SP6GK/Presto-Transverter/ECAD/Simulations_0006_PrestoMB/TPS26600 - Design Calculator Rev1p0.xlsx

Sheet: Calculation Sheet
TPS26600 Design Calculator Tool
Constants Cells | Input / Select Cells | Calculation Cells
 | Calculated, but can be over-ridden by the user. Note: Once cells are over-ridden, new calculation sheet should be used for the next design
Parameter | Description | Value | Units | Tolerance
VIN (max) | Maximum System Input Voltage | 14.0 | V
UVset | Undervoltage Lockout Threshold | 8.00 | V
OVset | Over Voltage Cut-Off Threshold | 16.00 | V
Cout | Load Capacitance | 330.0 | µF | 10%
TA (max) | Maximum Ambient Temperature | TA = 85C | °C
RLstart | Load during start-up (Assumed to be resistive) | 30.0 | Ω
Imax | Maximum continuous load current | 1.0 | A
ILimit | Current Limit, 10% higher than the maximum continuous load current | 1.10 | A
UVLO, OVP Calculations
R3_sel | Select a value in the range from 10k to 249k | 33.0 | kΩ | 1.0% |  |  |  | 330
R2_cal | Calculated value of Resistor at UVLO pin | 33.0 | kΩ |  |  | 7.69 | Power Fail (VIN Falling) | 330
R1_cal | Calculated value of Resistor at IN pin | 377.7 | kΩ |  |  | 8.32 | UVLO (VIN Rising) | 377.697479
SELECT THE CLOSEST POSSIBLE RESISTANCE VALUE FOR R1, R2, R3 |  |  |  |  |  | 16.84 | OVP (VIN Rising)
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
