SP6GK/Presto-Transverter/ECAD/KiCad_0006_PrestoMB_rev01a/ScoreS3.png

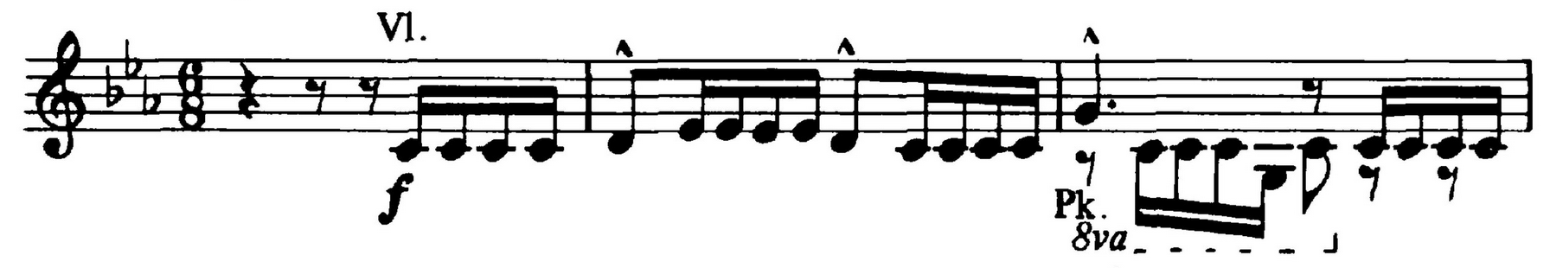
ECAD/KiCad_0006_PrestoMB_rev01a/ScoreS3.png
