SP6GK/Presto-Transverter/Photos/CH_under_development2.png

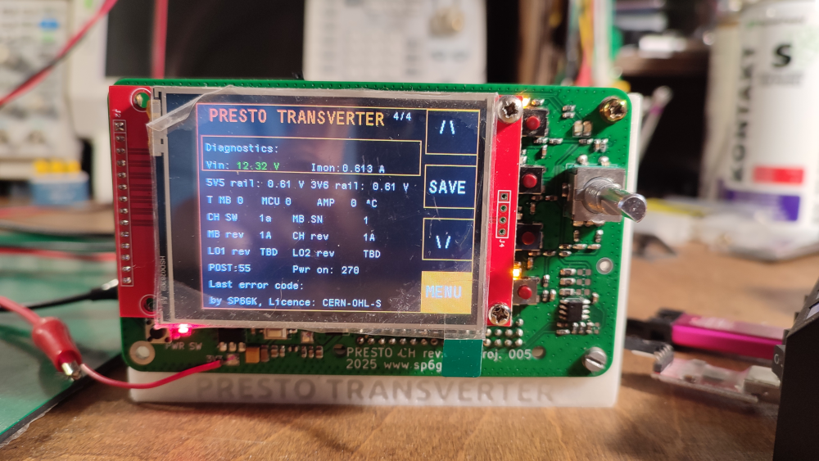
Photos/CH_under_development2.png
