SP6GK/Presto-Transverter/Photos/CH_under_development3.png

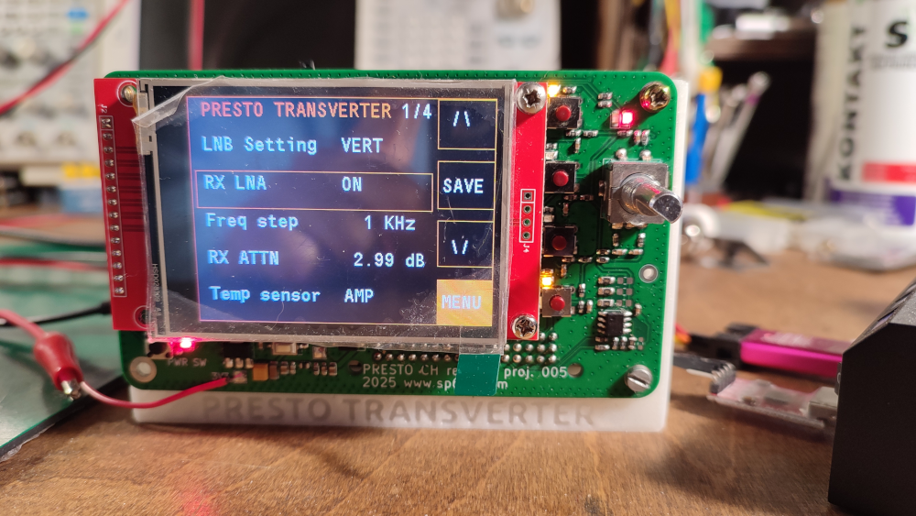
Photos/CH_under_development3.png
