SP6GK/Presto-Transverter/Photos/IMG_20250809_144910.jpg

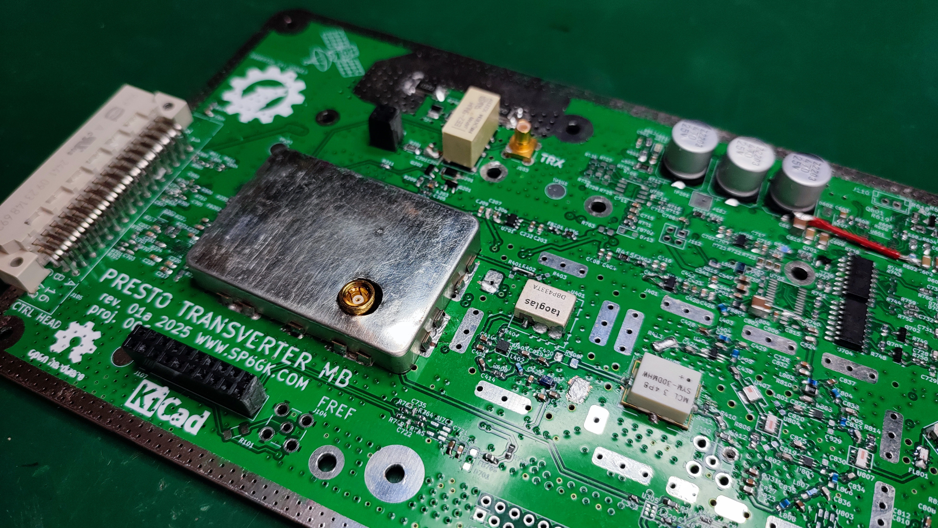
Photos/IMG_20250809_144910.jpg
