SP6GK/Presto-Transverter/Photos/IMG_20250809_145022.jpg

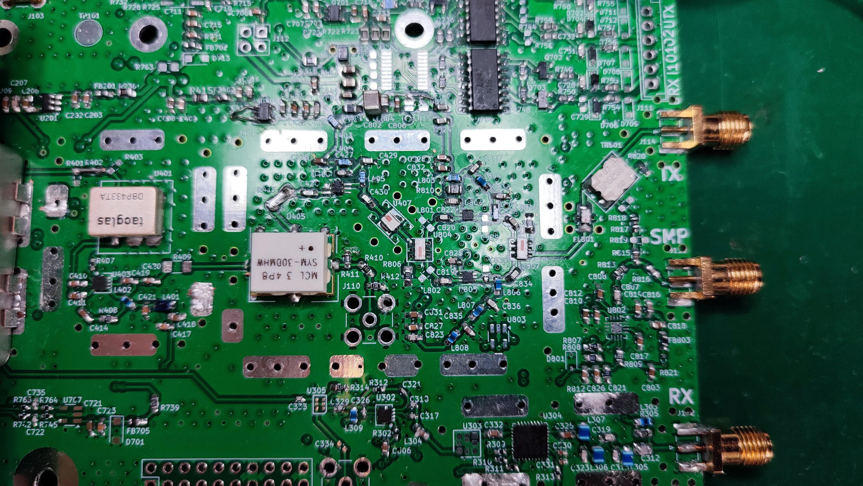
Photos/IMG_20250809_145022.jpg
