SP6GK/Presto-Transverter/Photos/IMG_20250809_145121.jpg

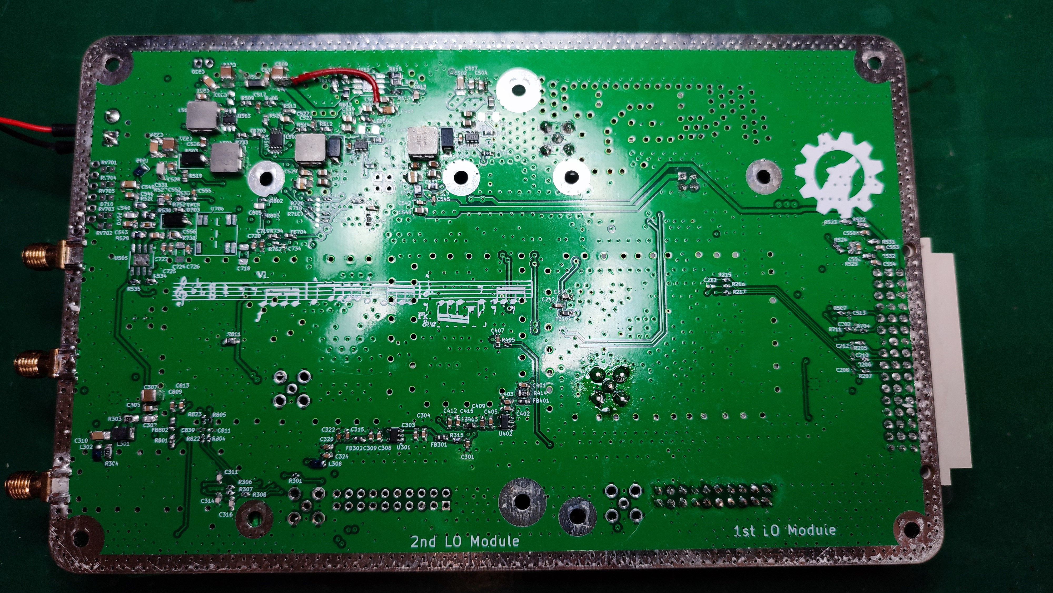
Photos/IMG_20250809_145121.jpg
