SP6GK/Presto-Transverter/Photos/IMG_20250809_145201.jpg

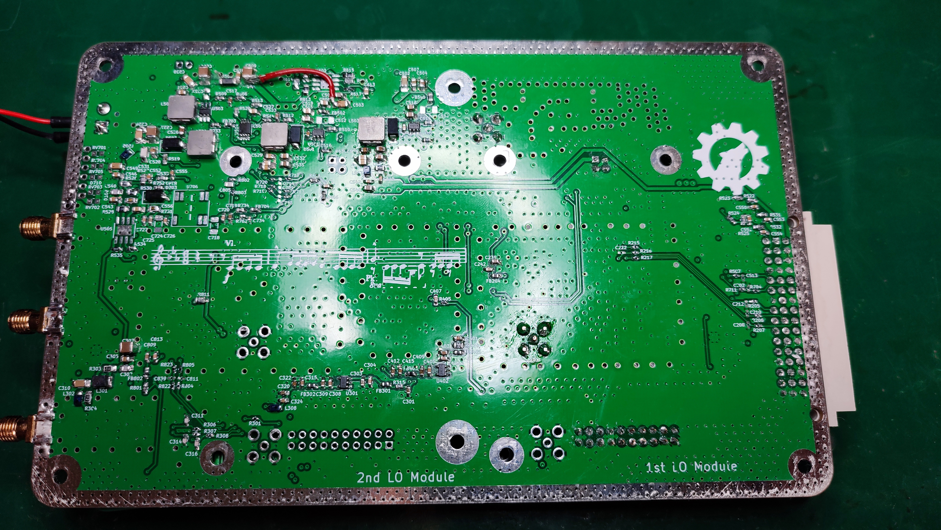
Photos/IMG_20250809_145201.jpg
