SP6GK/Presto-Transverter/Photos/IMG_20261025_150856.jpg

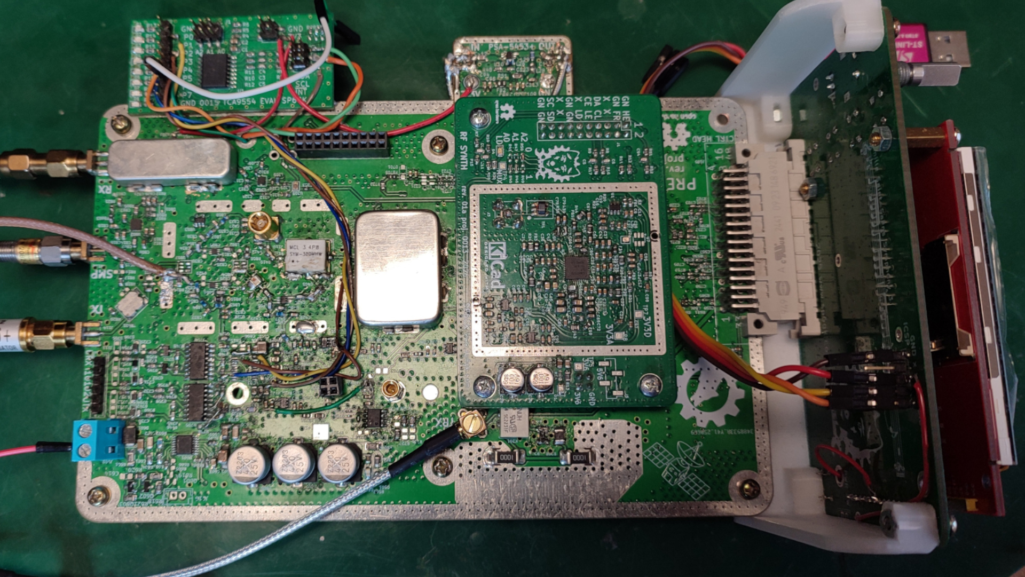
Photos/IMG_20261025_150856.jpg
