SP6GK/Presto-Transverter/MCAD/MCAD_0006_PrestoMB_rev01a/Presto_Assembly-Back_Support.stl

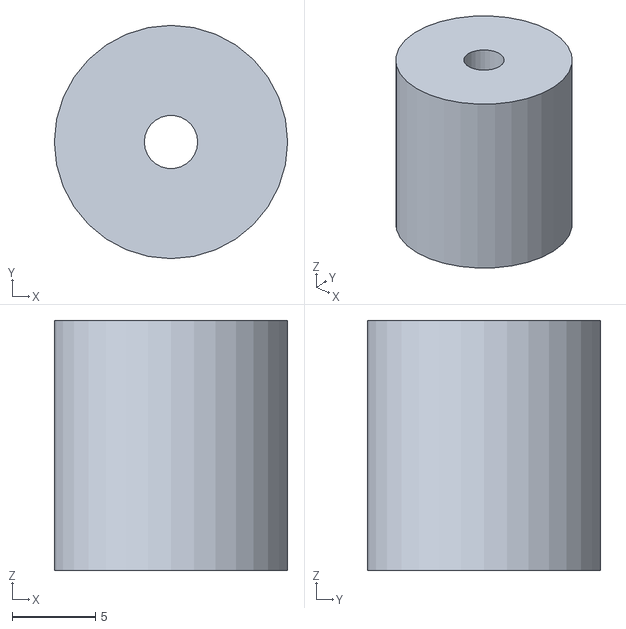
[picture p14: CAD file, 2026-10-25]
MCAD/MCAD_0006_PrestoMB_rev01a/Presto_Assembly-Back_Support.stl
14.0 x 14.0 x 15.0
