SP6GK/Presto-Transverter/MCAD/MCAD_0006_PrestoMB_rev01a/Presto_Assembly.FCStd

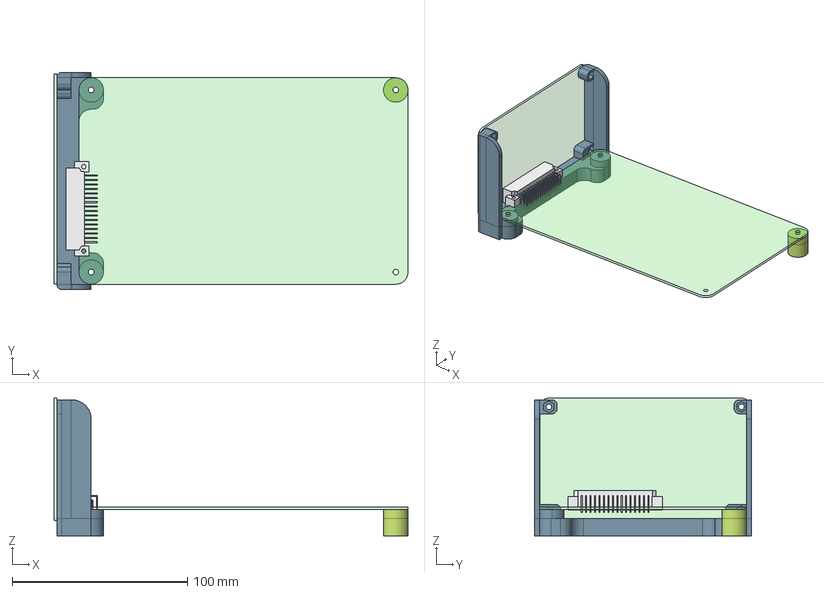
[picture p15: CAD file, 2026-10-25]
MCAD/MCAD_0006_PrestoMB_rev01a/Presto_Assembly.FCStd
202.3 x 124.0 x 78.8 mm
Presto_MB
MD_09231102020300_100073003ugm000_b
Presto_CH
Front_frame
Back_Support
