SP6GK/Presto-Transverter/MCAD/MCAD_0006_PrestoMB_rev01a/Presto_Assembly-Front_frame.stl

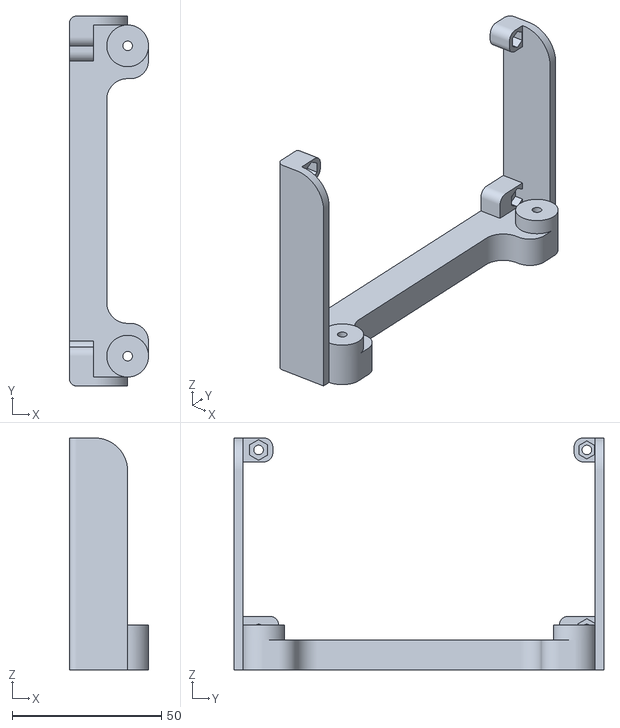
[picture p16: CAD file, 2026-10-25]
MCAD/MCAD_0006_PrestoMB_rev01a/Presto_Assembly-Front_frame.stl
26.5 x 124.0 x 77.8
