SP6GK/Presto-Transverter/MCAD/MCAD_0006_PrestoMB_rev01a/09232486824.stp

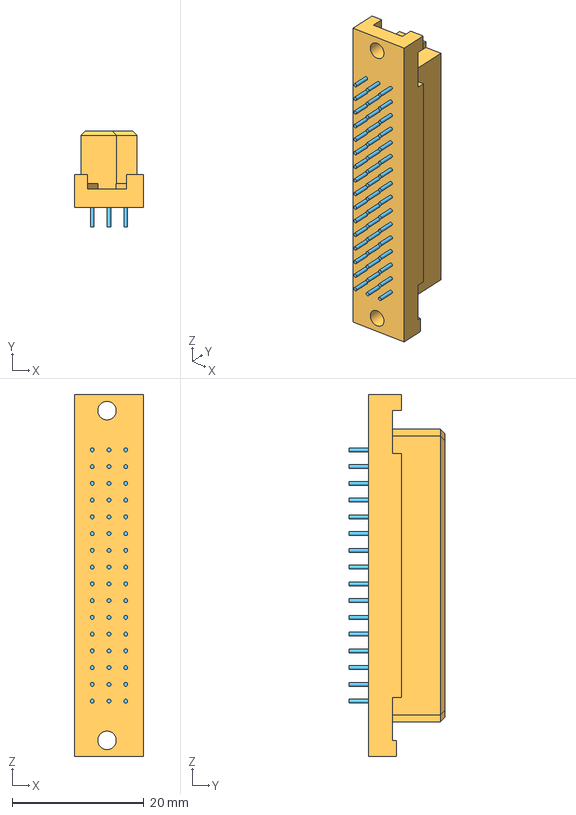
[picture p17: CAD file, 2026-10-25]
MCAD/MCAD_0006_PrestoMB_rev01a/09232486824.stp
10.5 x 14.5 x 54.9 mm
