SP6GK/Presto-Transverter/MCAD/MCAD_0006_PrestoMB_rev01a/09231486921.stp

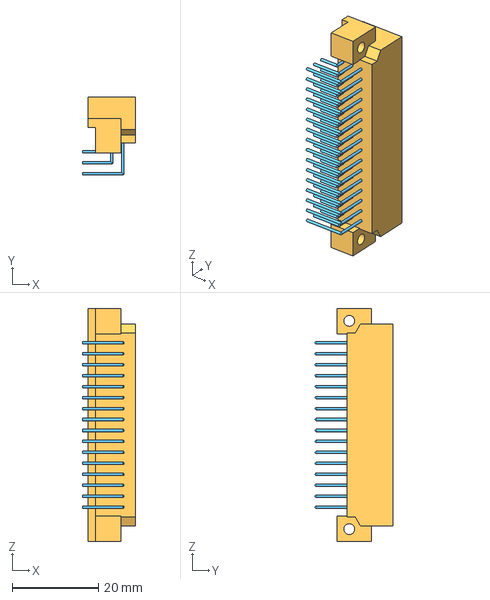
[picture p18: CAD file, 2026-10-25]
MCAD/MCAD_0006_PrestoMB_rev01a/09231486921.stp
12.4 x 18.0 x 54.0 mm
