SP6GK/Presto-Transverter/Verification/Measurements/TX_IF_Wide_AMP_OFF.png

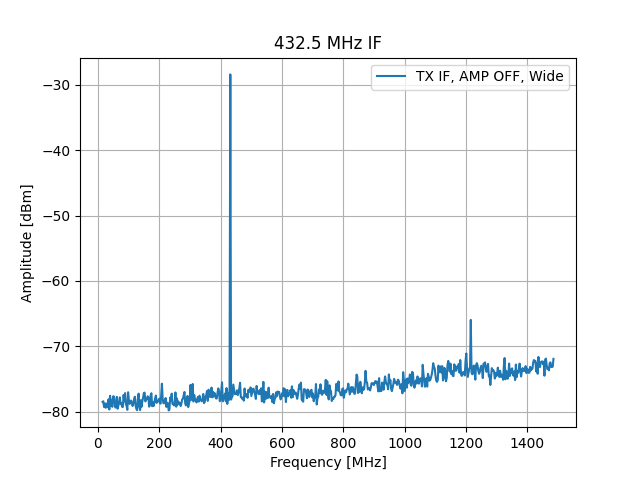
Verification/Measurements/TX_IF_Wide_AMP_OFF.png
