SP6GK/Presto-Transverter/Verification/Measurements/TX_MIX_OUT_TO_OUTPUT.png

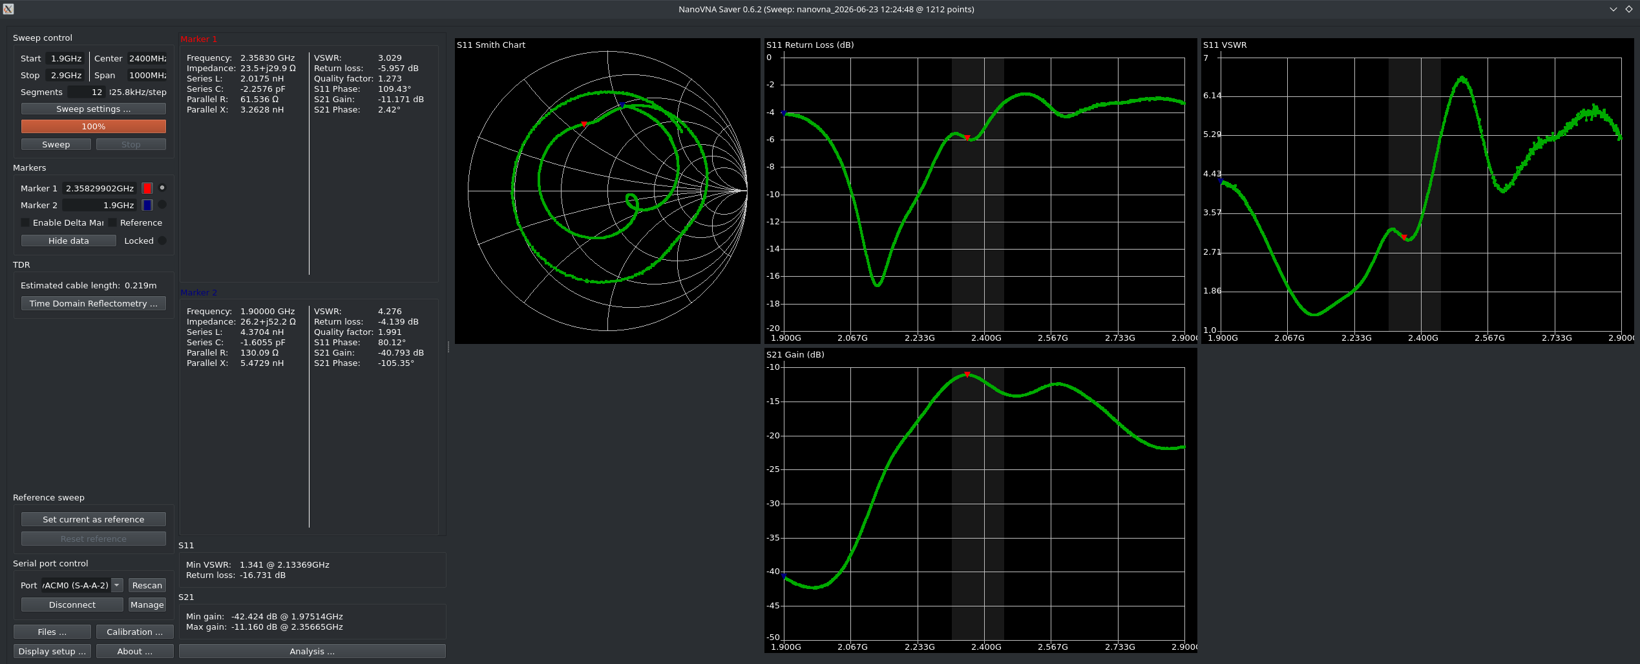
Verification/Measurements/TX_MIX_OUT_TO_OUTPUT.png
