SP6GK/Presto-Transverter/Documents/Transverter_CAD.pdf

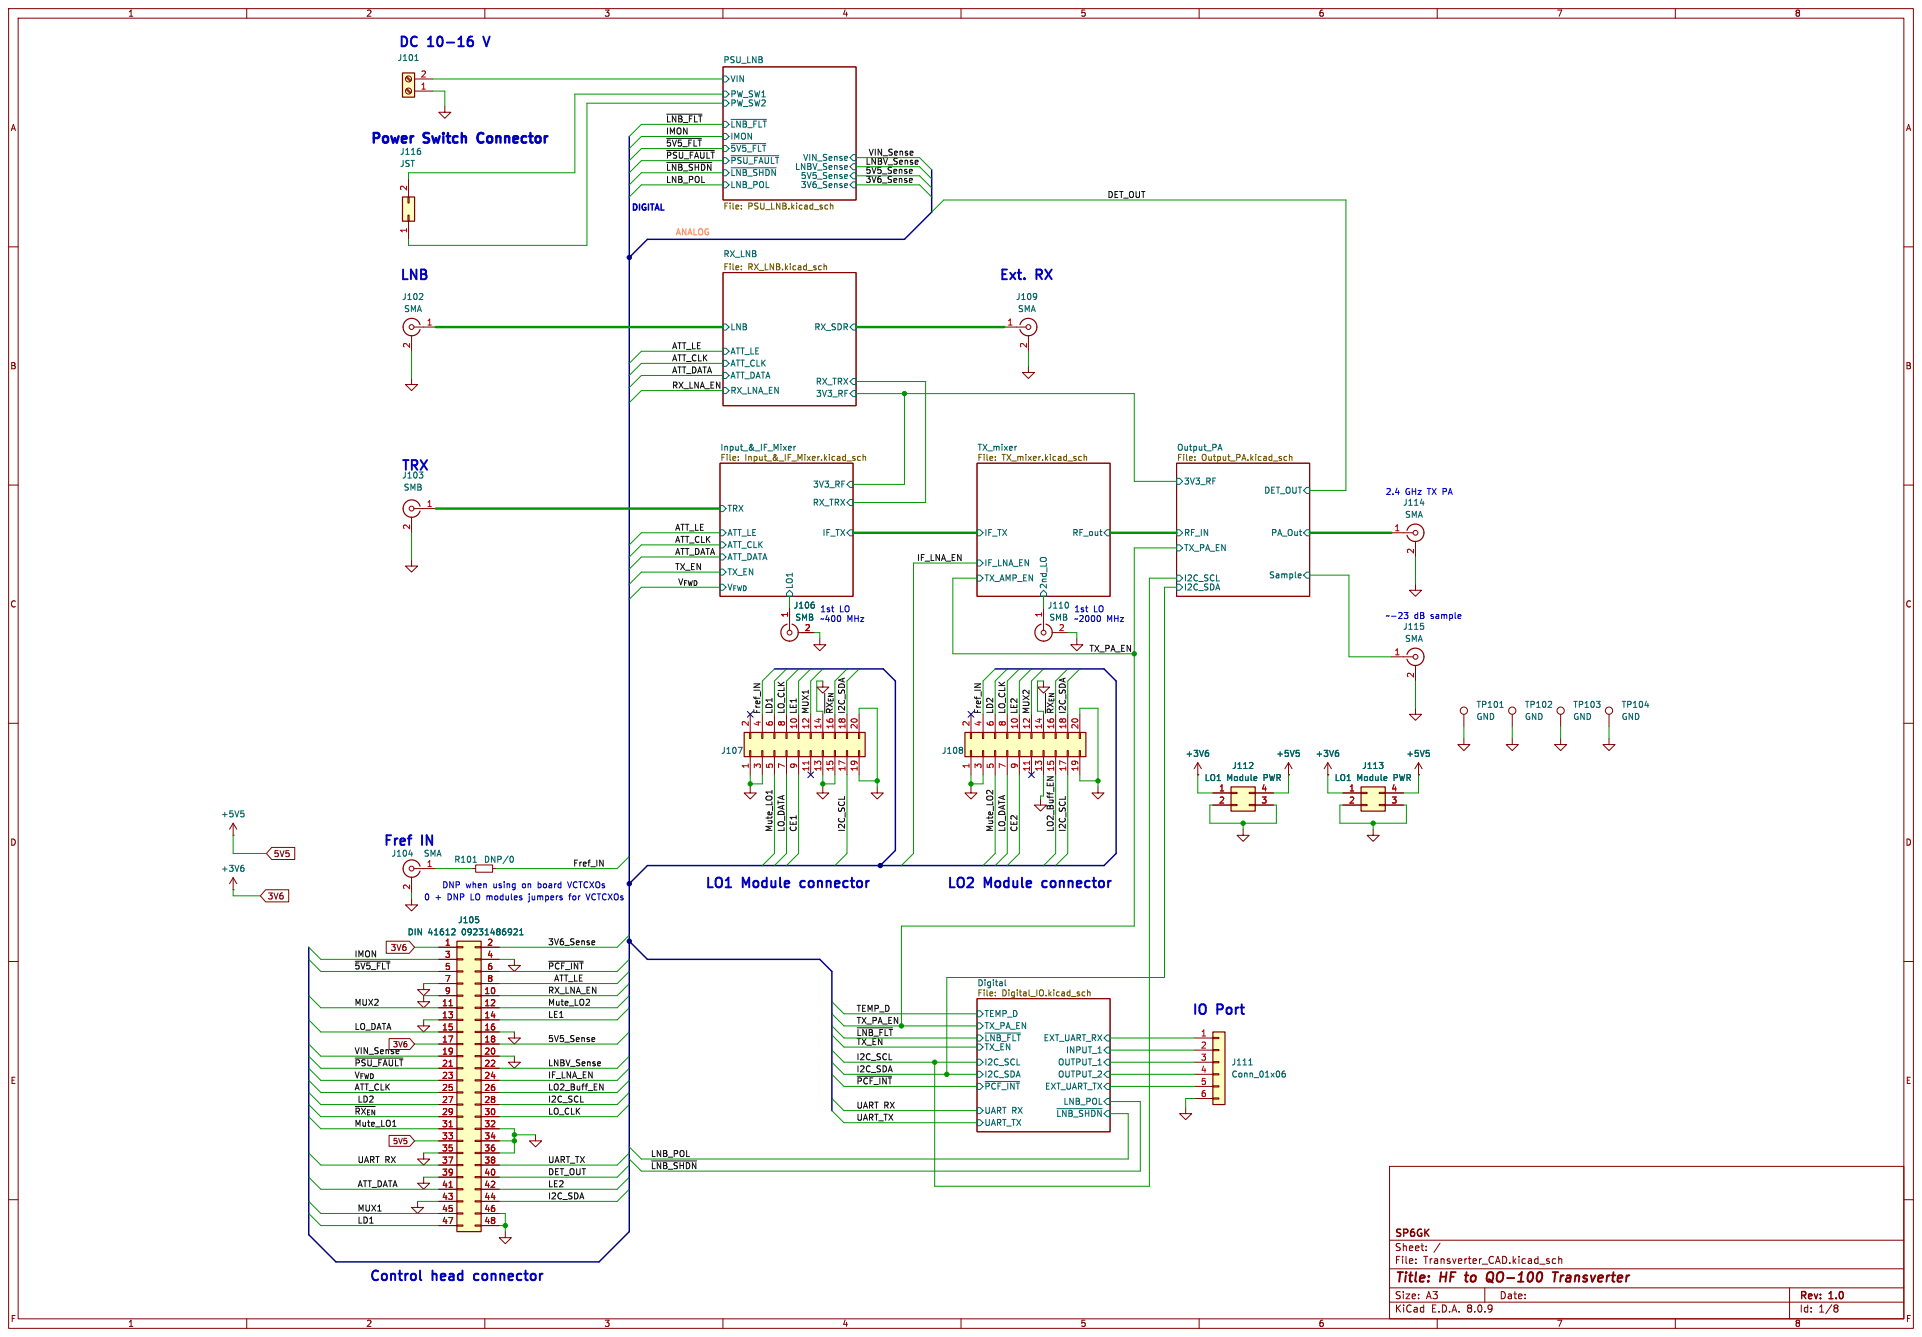
[picture p40: page 1]

DIGITAL 0 + DNP LO modules jumpers for VCTCXOs

2.4 GHz TX PA LNB
J102 SMA 1 2

~-23 dB sample DNP when using on board VCTCXOs

~2000 MHz Control head connector

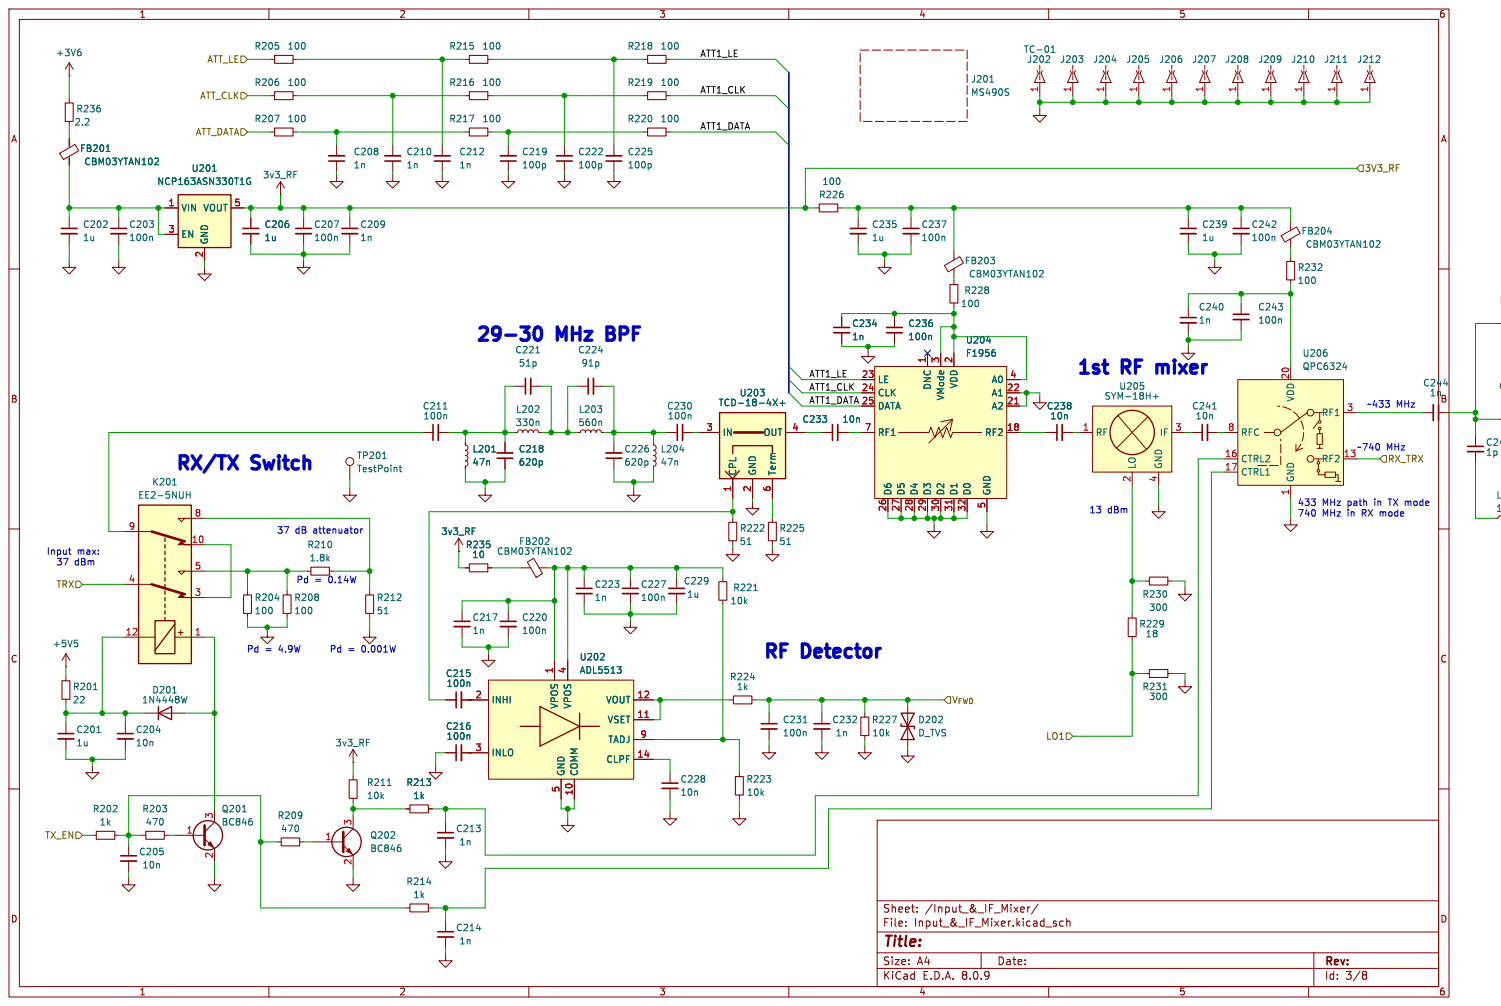
[picture p41: page 2]

~433 MHz RX/TX Switch

433 MHz path in TX mode

740 MHz in RX mode Pd = 0.14W

1 COMM 10 VSET 11 VOUT 12 CLPF 14

Id: 3/8 Title: File: Input_&_IF_Mixer.kicad_sch Sheet: /Input_&_IF_Mixer/

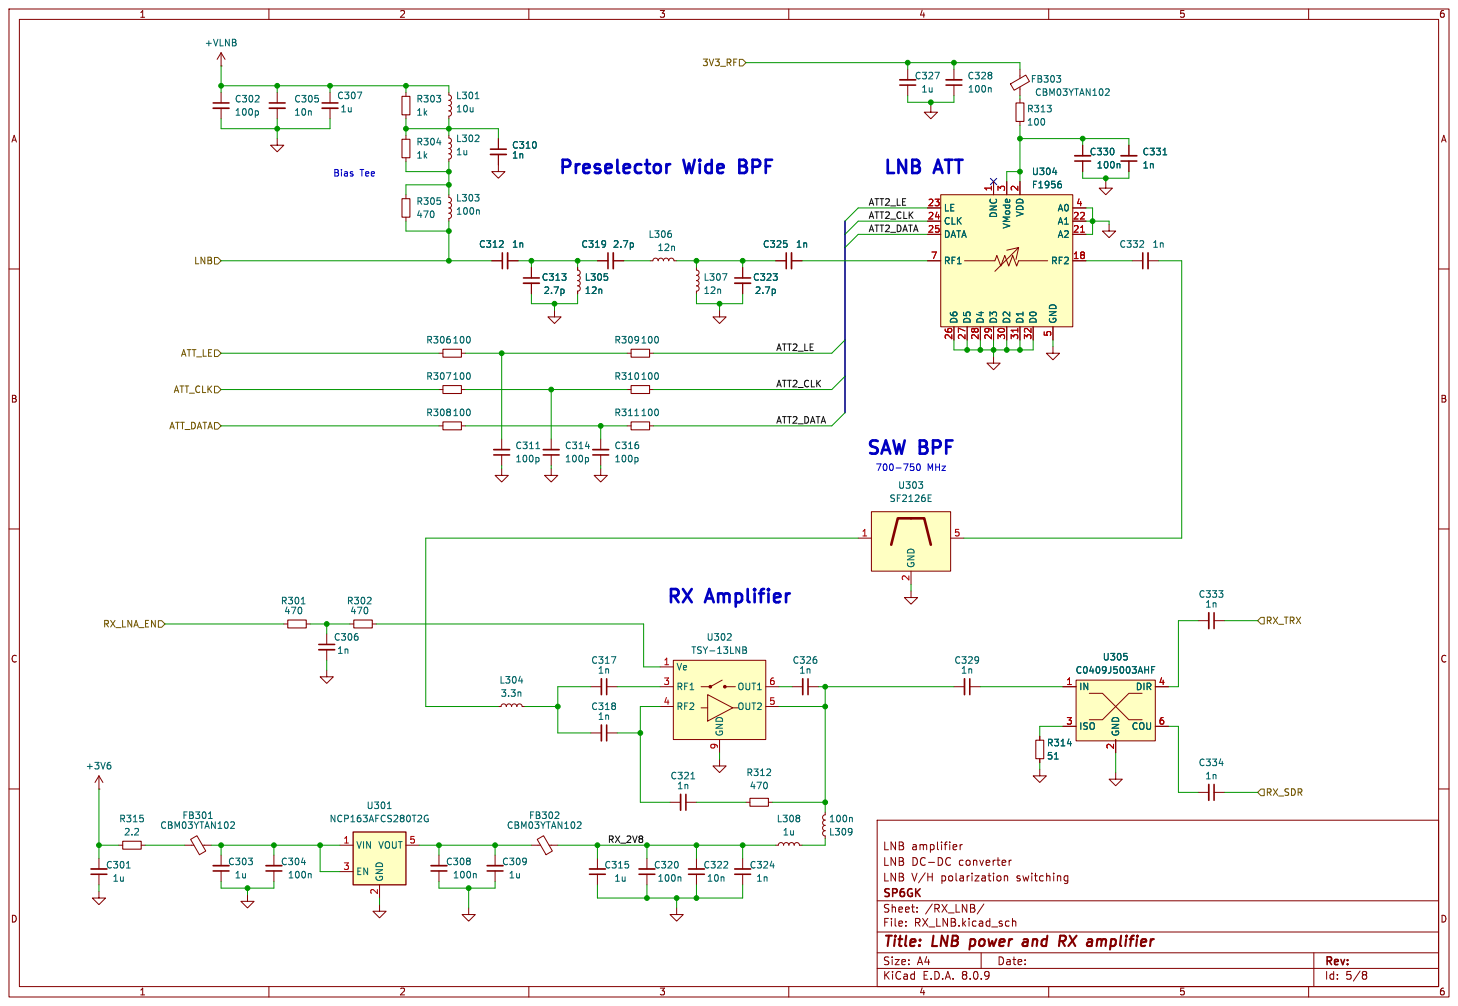
[picture p42: page 3]

Id: 5/8 Title: LNB power and RX amplifier File: RX_LNB.kicad_sch Sheet: /RX_LNB/ SP6GK

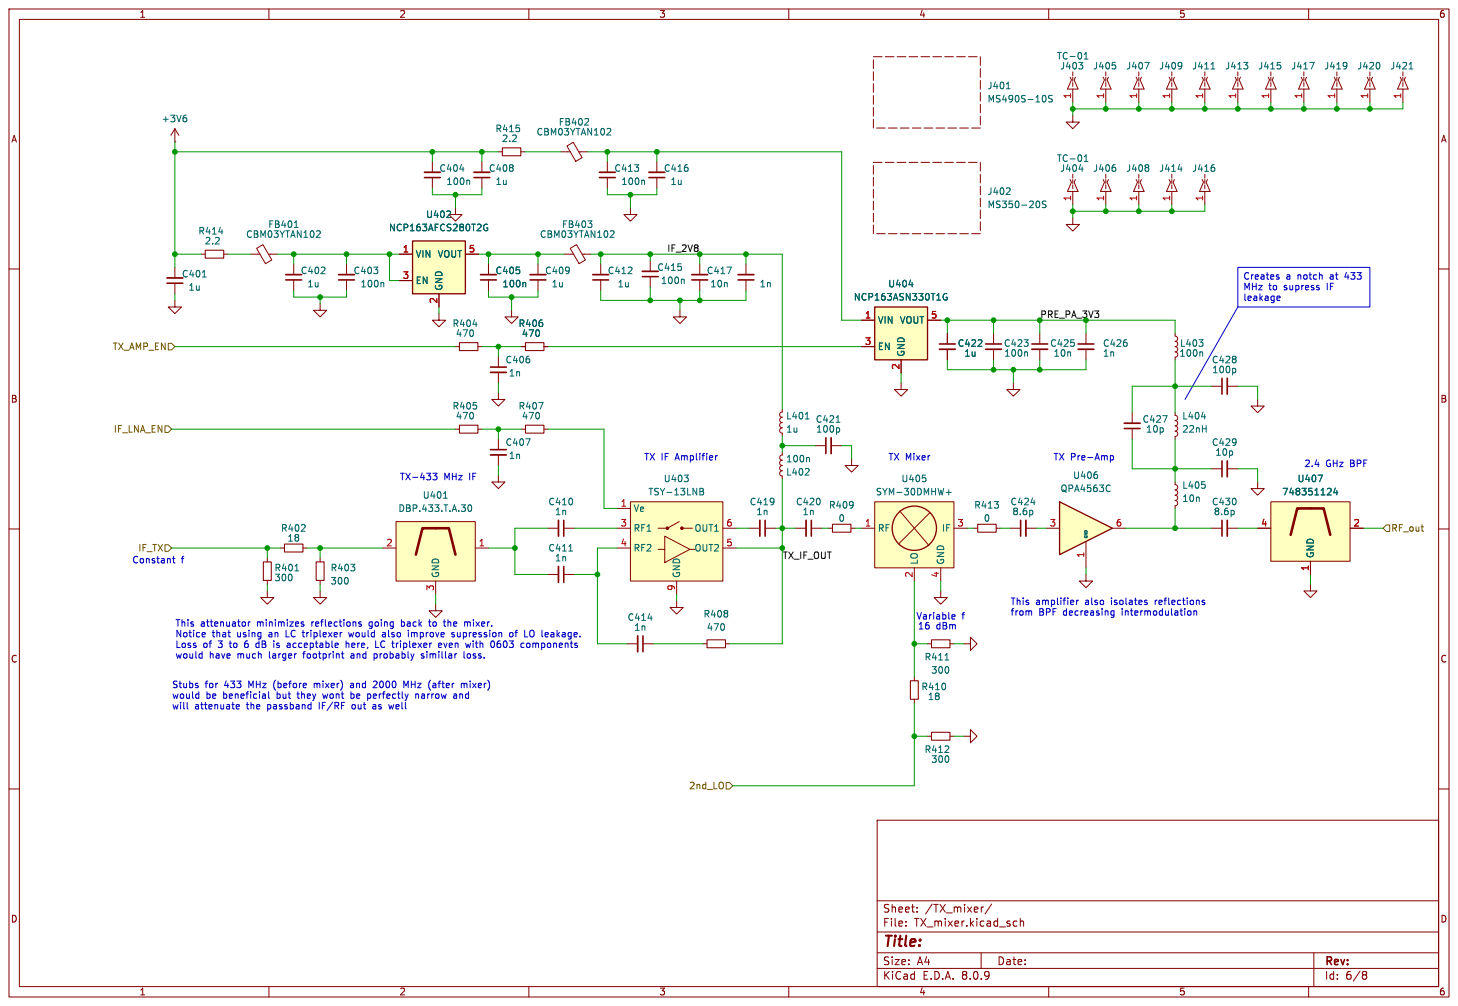
[picture p43: page 4]

Id: 6/8 Title: File: TX_mixer.kicad_sch Sheet: /TX_mixer/

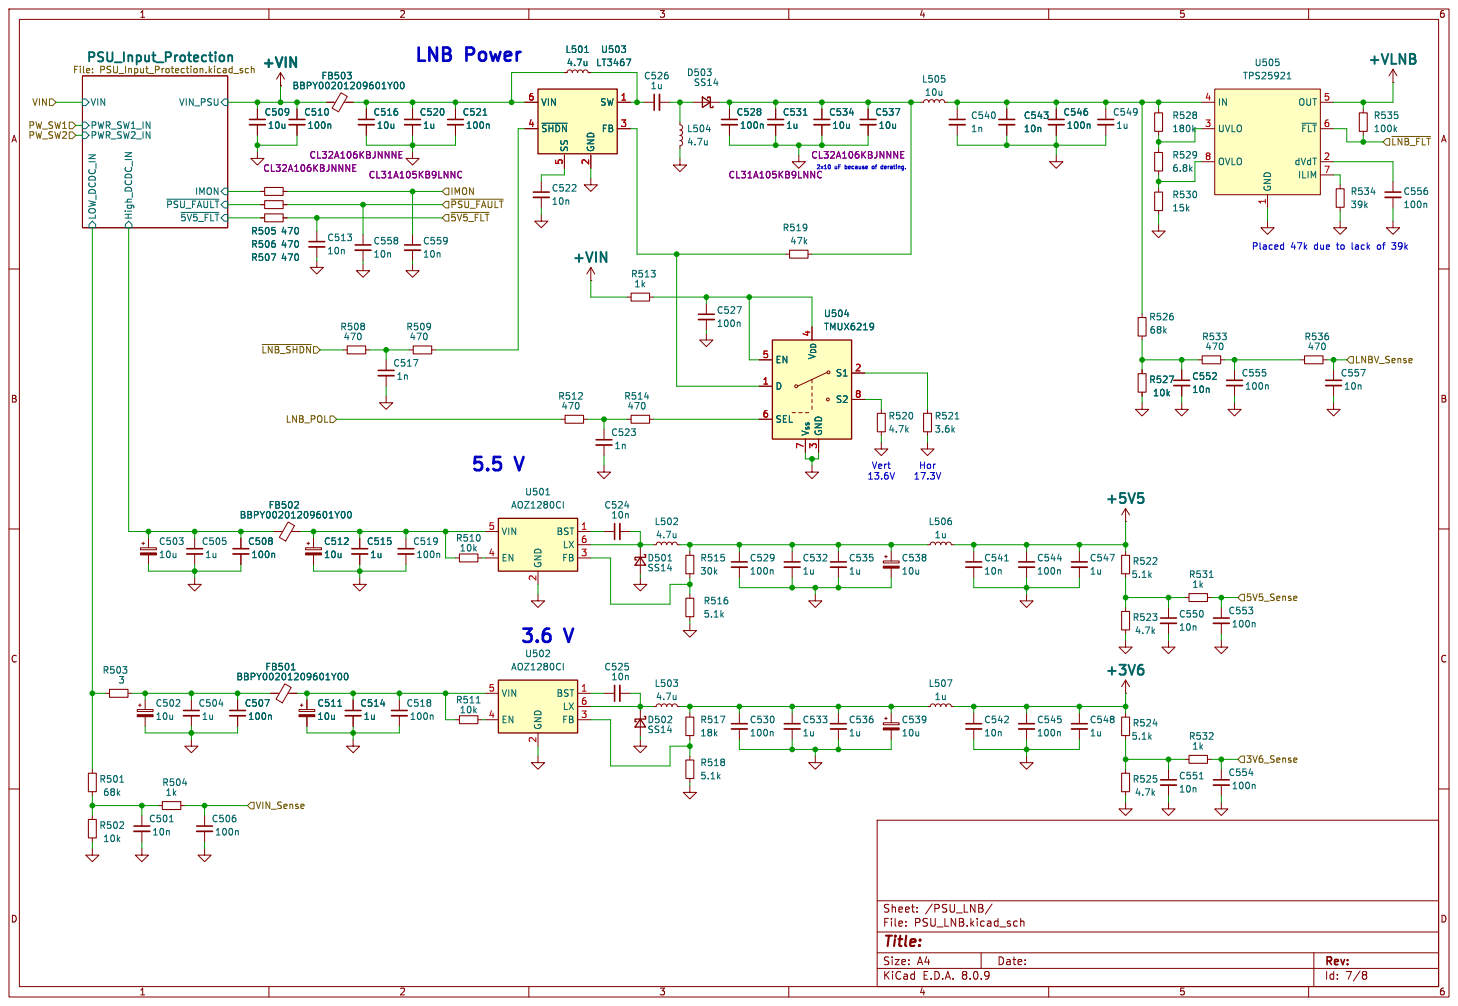
[picture p44: page 5]

3 V_{DD} 4 EN 5 SEL 6 V_{ss} 7 S2 8 U504 TMUX6219 C512

3 V_{DD} 4 EN 5 SEL 6 V_{ss} 7 S2 8 C507

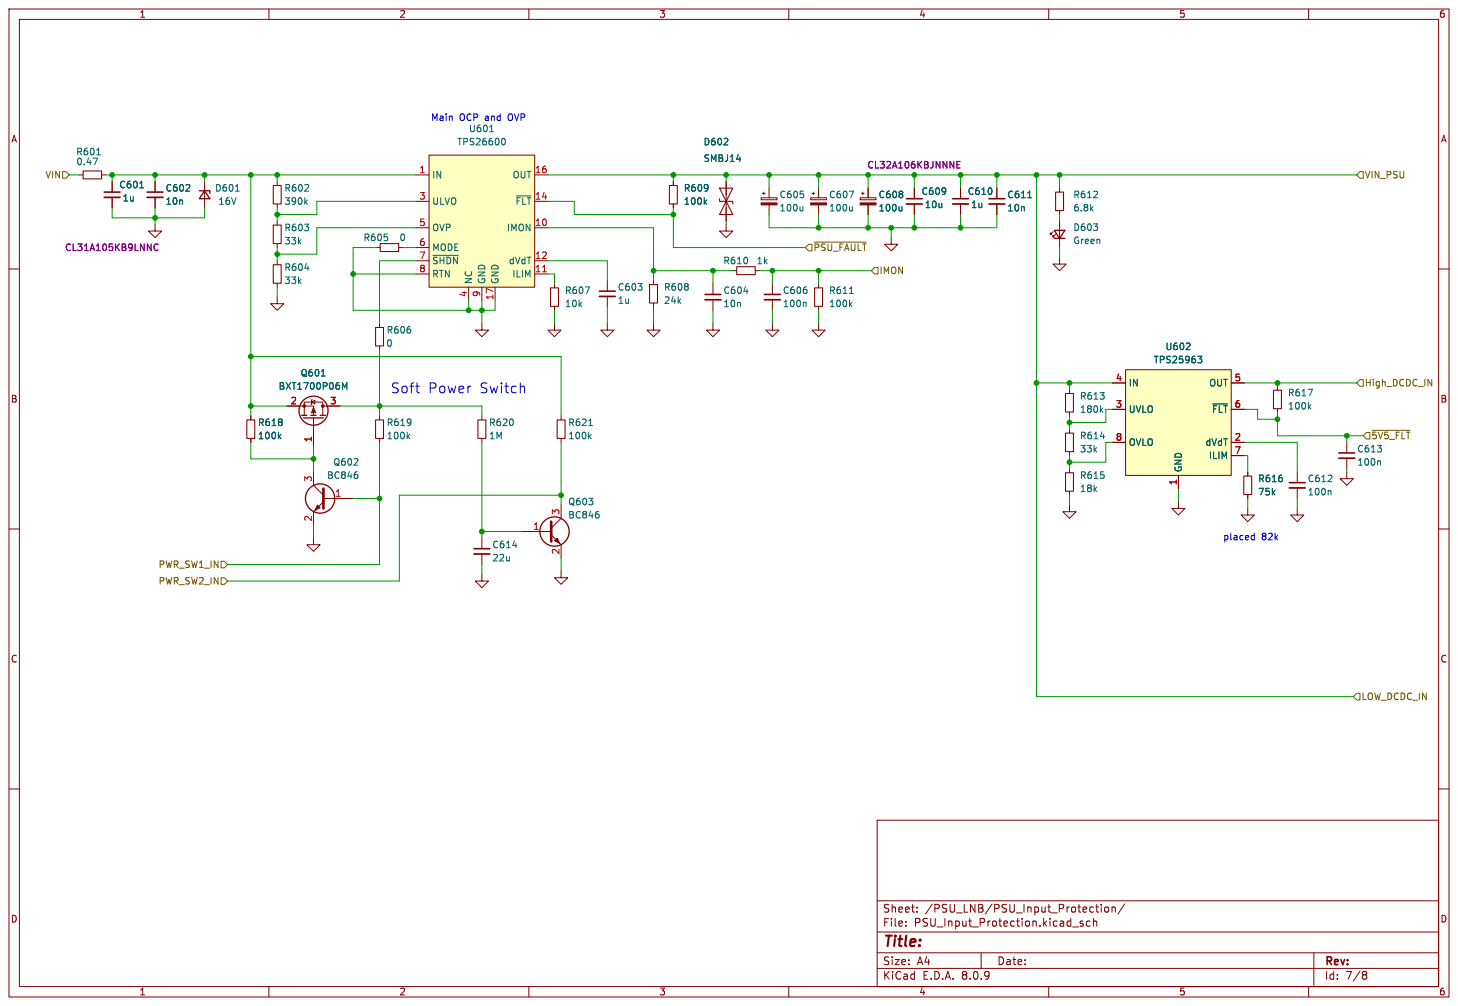
[picture p45: page 6]

placed 82k Main OCP and OVP Soft Power Switch

4 OVP 5 MODE 6 ~{SHDN} 7 RTN 8 GND

Id: 7/8 Title: File: PSU_Input_Protection.kicad_sch Sheet: /PSU_LNB/PSU_Input_Protection/

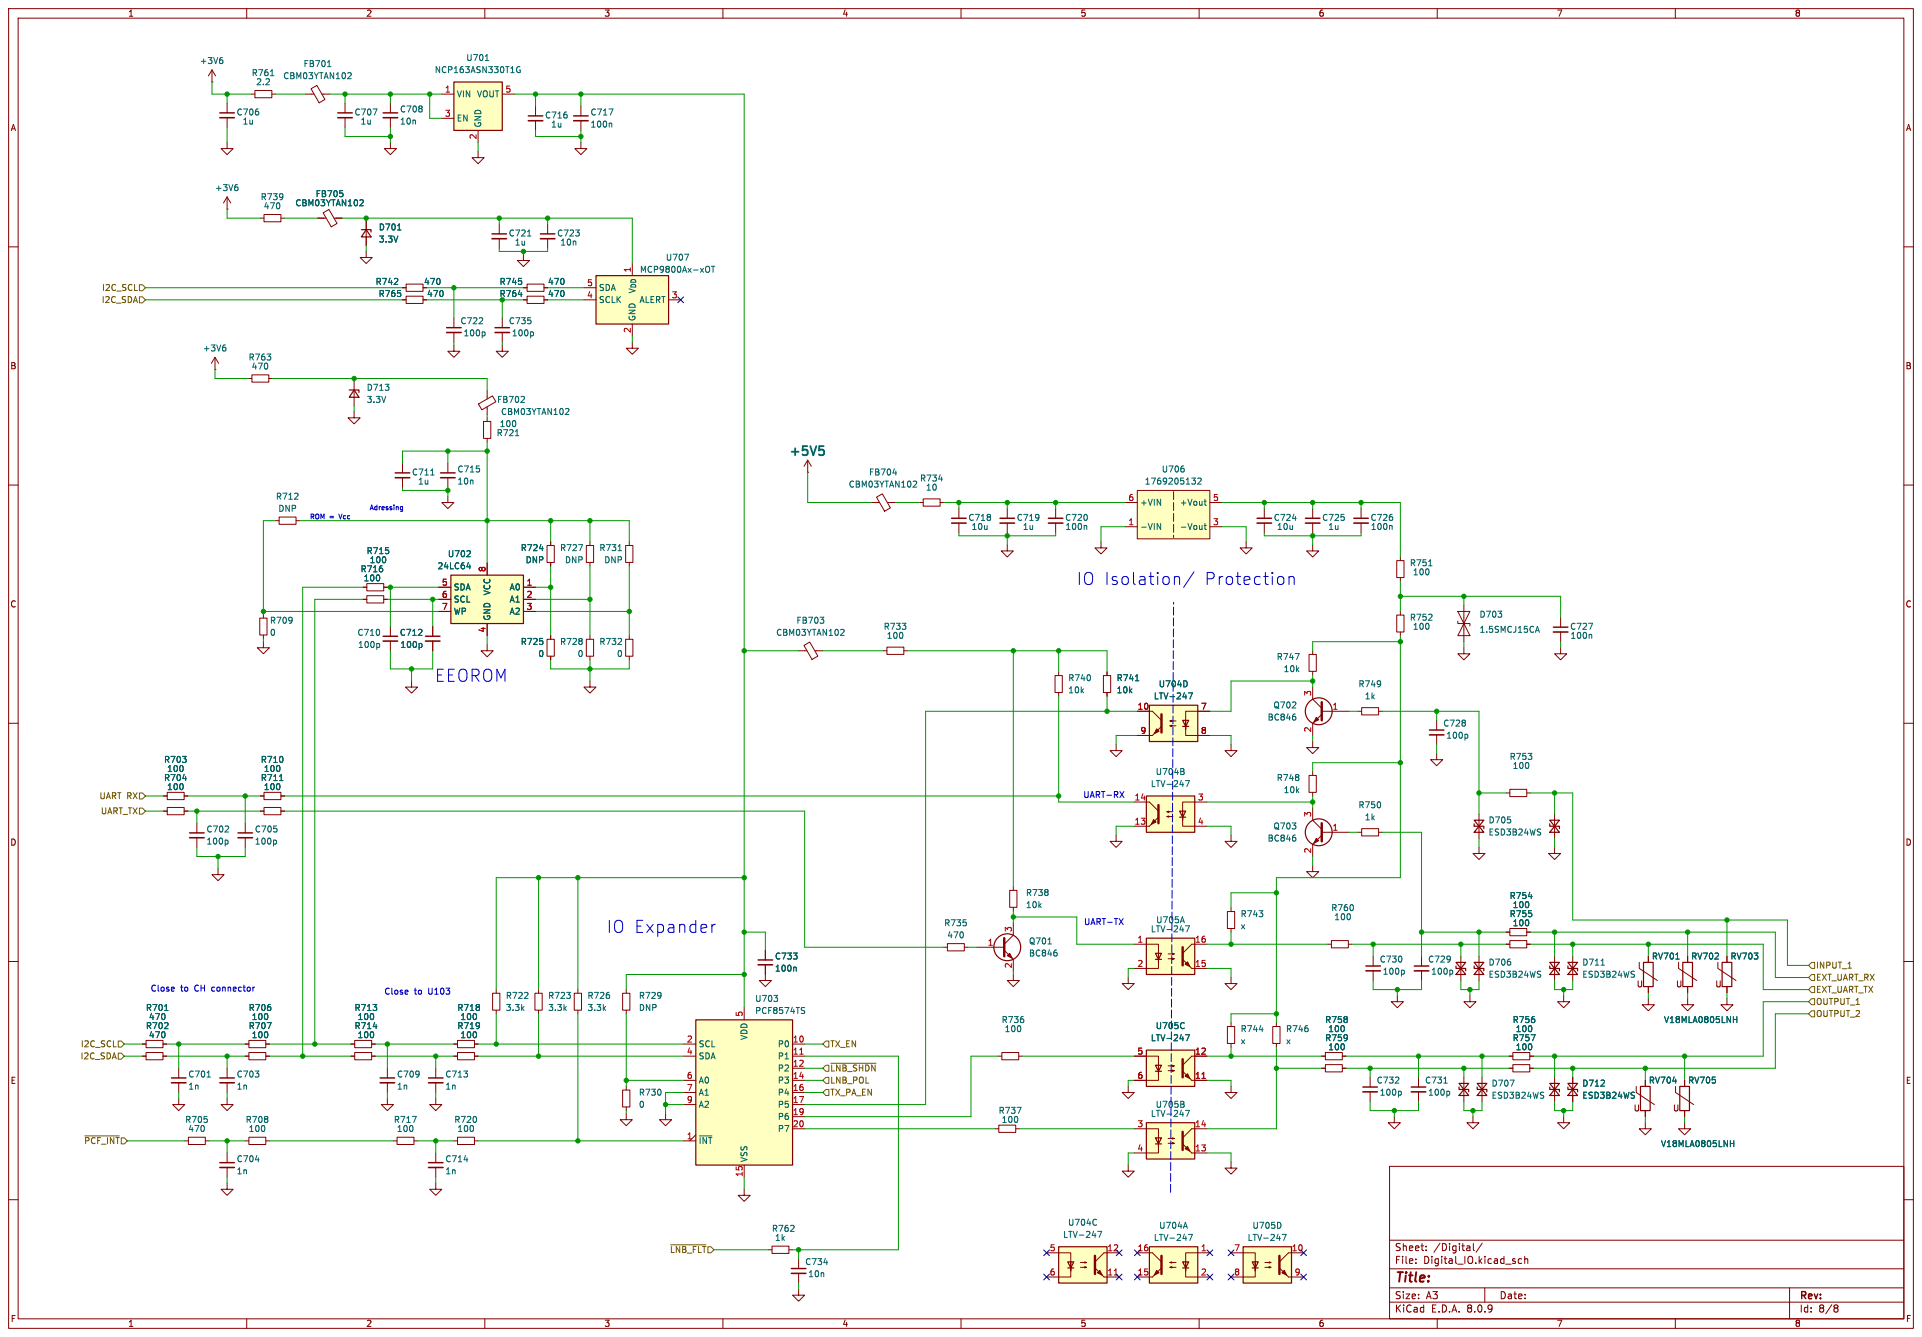
[picture p46: page 7]

2 ALERT 3 SCLK 4 SDA 5 U707 MCP9800Ax-xOT R731 DNP R721

4 SDA 5 SCL 6 WP 7 VCC

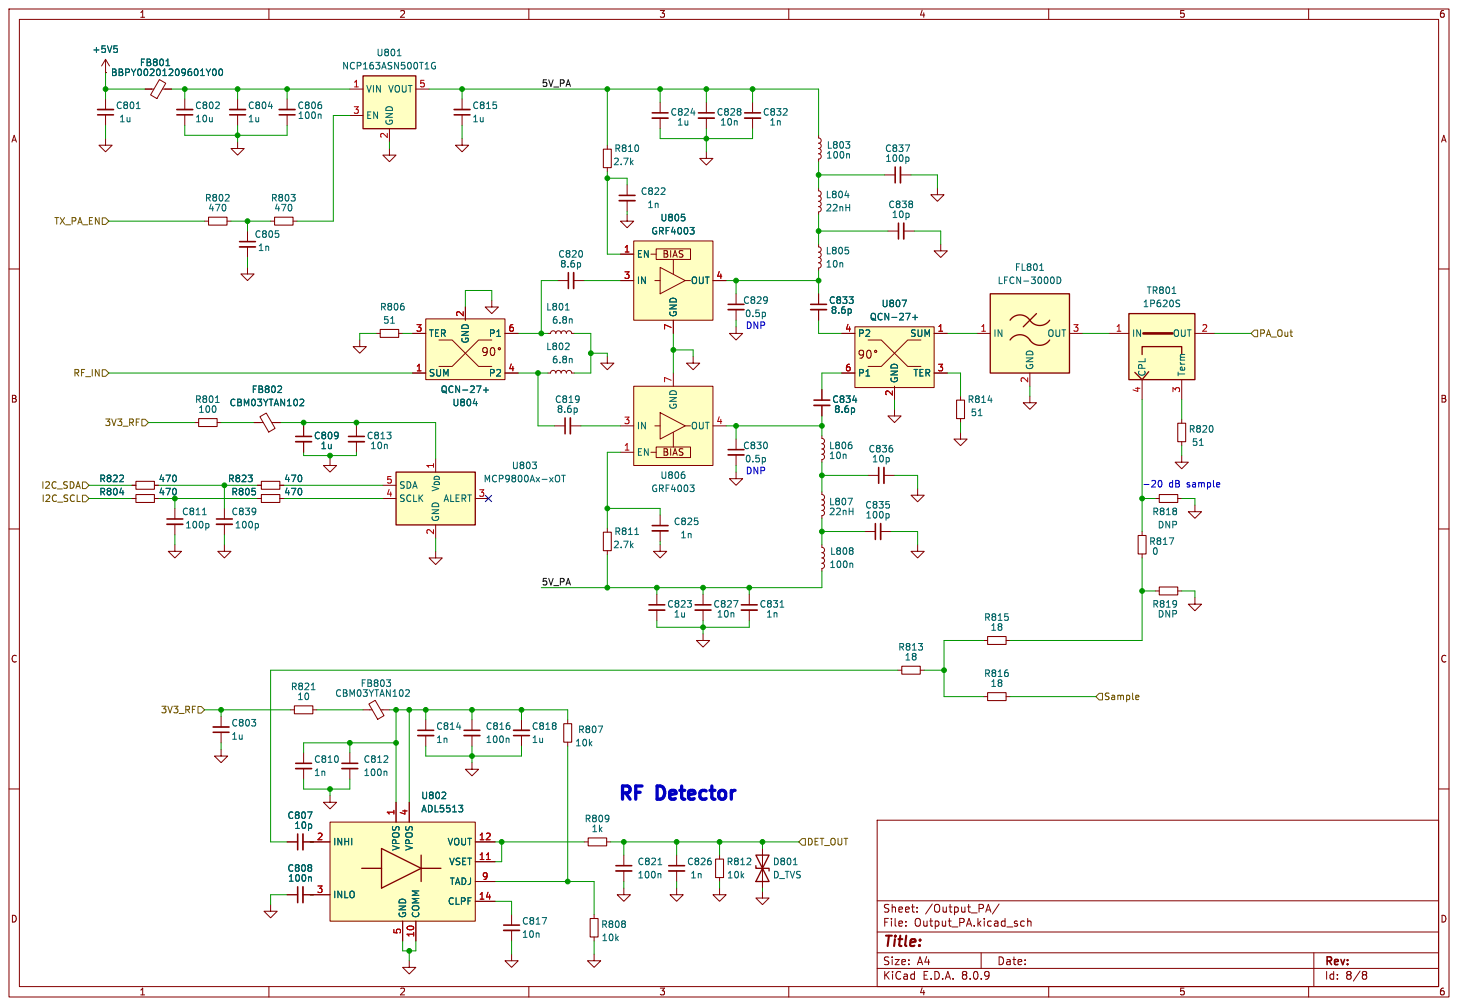
[picture p47: page 8]

2 TER 3 P2 4 P1 6 U807 QCN-27+ FB803 CBM03YTAN102 V_{DD} 1 GND

2 ALERT 3 SCLK 4 SDA 5 U803 MCP9800Ax-xOT C818

1 COMM 10 VSET 11 VOUT 12 CLPF 14

Id: 8/8 Title: File: Output_PA.kicad_sch Sheet: /Output_PA/
