SP6GK/Presto-Transverter/ECAD/Simulations_0006_PrestoMB/Draft1.asc

D1: diode
D2: diode
D3: diode
D4: diode
L1: ind; 1µ
L2: ind; 1µ
L3: ind; 1µ
L4: ind; 1µ
L5: ind; 1µ
L6: ind; 1µ
R1: res; 50
Named nets: 0
