SP6GK/Presto-Transverter/ECAD/Simulations_0006_PrestoMB/LNB_PSU_LT3467.asc

C1: cap; 4.7µ
C2: cap; 10µ
C3: cap; 10p
C4: cap; 100n
C5: cap; 10µ
D2: SCHOTTKY; MBRS130L
Iload: LOAD2; 75m; load
L1: ind; 4.7µ; Rser=1 Rpar=1K
L2: ind; 4.7µ; Rser=1 Rpar=1K
R1: RES; 47k
R2: RES; {Rpol}
R3: res; 1
U1: LT3467
V1: VOLTAGE; 8
V2: voltage; 3
Named nets: OUT, 0, IN
.tran 0 15m 1m startup
;.step param VIN list 8 12 16
.step param Rpol list 4.7k 3.6k
