SP6GK/Presto-Transverter/ECAD/KiCad_0006_PrestoMB_rev01a/0006_PrestoMB.kicad_pcb

## KiCad design ECAD/KiCad_0006_PrestoMB_rev01a/0006_PrestoMB.kicad_pcb (2026-10-25)

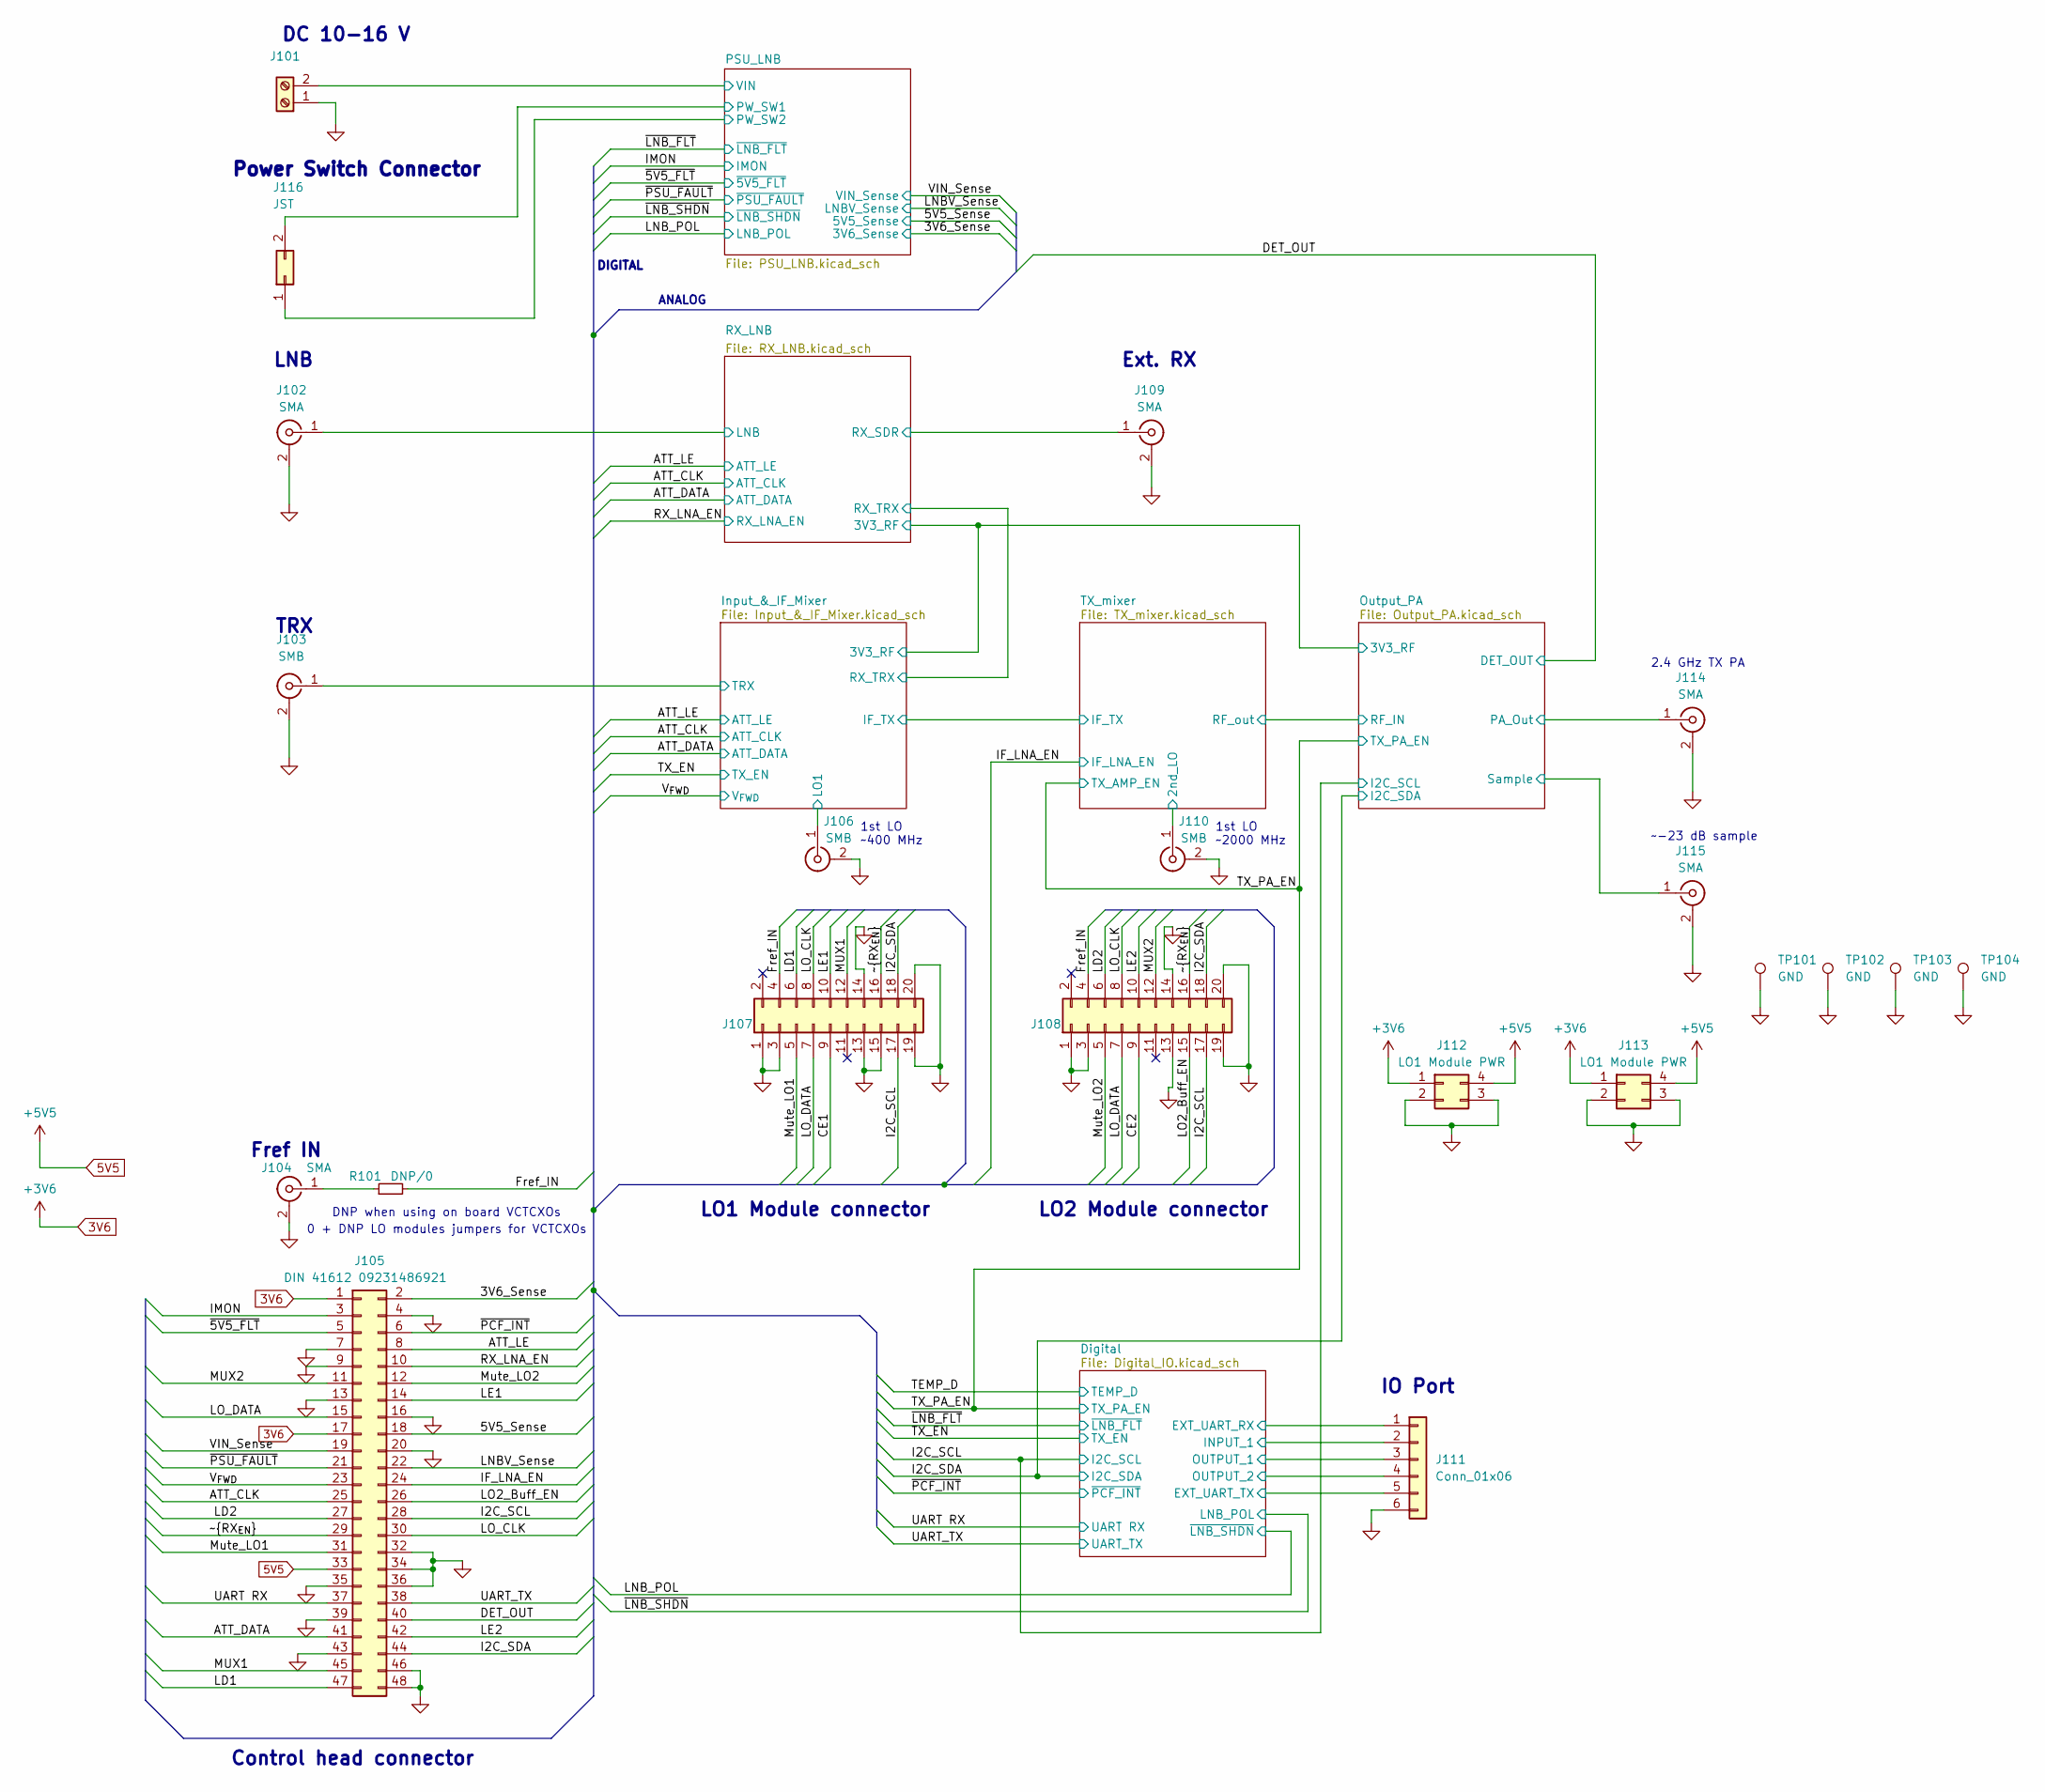
[picture p48: schematic 0006_PrestoMB.kicad_sch, Presto transverter]

Parts:
J101: Screw_Terminal_01x02; TerminalBlock_bornier-2_P5.08mm
J102, J114, J115: SMA; SMA_Samtec_SMA-J-P-H-ST-EM1_EdgeMount
J103, J106, J110: SMB; SMB_Jack_Vertical
J104, J109: SMA; SMB_Jack_Vertical
J105: DIN 41612 09231486921; DIN_41612_48Pin_90angle_Male_09231486921HARTING
J107, J108: LO1 Connector; PinHeader_2x10_P2.54mm_Vertical
J111: Conn_01x06; JST_EH_B6B-EH-A_1x06_P2.50mm_Vertical
J112, J113: LO1 Module PWR; PinHeader_2x02_P2.54mm_Vertical
J116: JST; JST_EH_B2B-EH-A_1x02_P2.50mm_Vertical
R101: DNP/0; R_1206_3216Metric_Pad1.30x1.75mm_HandSolder
TP101, TP102, TP103, TP104: GND; TestPoint_Pad_D4.0mm

Connections:
3V6: J105.1, J105.17, J112.1, J113.1; also elsewhere on the board
5V5: J105.33, J112.4, J113.4; also elsewhere on the board
/3V6_Sense: J105.2; also elsewhere on the board
/5V5_Sense: J105.18; also elsewhere on the board
/ATT_CLK: J105.25; also elsewhere on the board
/ATT_DATA: J105.41; also elsewhere on the board
/ATT_LE: J105.8; also elsewhere on the board
/CE1: J107.9
/CE2: J108.9
/DET_OUT: J105.40; also elsewhere on the board
/Digital/EXT_UART_RX: J111.1; also elsewhere on the board
/Digital/EXT_UART_TX: J111.5; also elsewhere on the board
/Digital/INPUT_1: J111.2; also elsewhere on the board
/Digital/OUTPUT_1: J111.3; also elsewhere on the board
/Digital/OUTPUT_2: J111.4; also elsewhere on the board
/Fref_IN: J107.4, J108.4, R101.2
/I2C_SCL: J105.28, J107.17, J108.17; also elsewhere on the board
/I2C_SDA: J105.44, J107.18, J108.18; also elsewhere on the board
/IF_LNA_EN: J105.24; also elsewhere on the board
/IMON: J105.3; also elsewhere on the board
/Input_&_IF_Mixer/LO1: J106.1 (In); also elsewhere on the board
/Input_&_IF_Mixer/TRX: J103.1 (In); also elsewhere on the board
/LD1: J105.47, J107.6
/LD2: J105.27, J108.6
/LE1: J105.14, J107.10
/LE2: J105.42, J108.10
/LNBV_Sense: J105.22; also elsewhere on the board
/LO2_Buff_EN: J105.26, J108.15
/LO_CLK: J105.30, J107.8, J108.8
/LO_DATA: J105.15, J107.7, J108.7
/MUX1: J105.45, J107.12
/MUX2: J105.11, J108.12
/Mute_LO1: J105.31, J107.5
/Mute_LO2: J105.12, J108.5
/Output_PA/PA_Out: J114.1 (In); also elsewhere on the board
/Output_PA/Sample: J115.1 (In); also elsewhere on the board
/PSU_LNB/PW_SW1: J116.2; also elsewhere on the board
/PSU_LNB/PW_SW2: J116.1; also elsewhere on the board
/PSU_LNB/VIN: J101.2; also elsewhere on the board
/RX_LNA_EN: J105.10; also elsewhere on the board
/RX_LNB/LNB: J102.1 (In); also elsewhere on the board
/RX_LNB/RX_SDR: J109.1 (In); also elsewhere on the board
/TX_mixer/2nd_LO: J110.1 (In); also elsewhere on the board
/UART RX: J105.37; also elsewhere on the board
/UART_TX: J105.38; also elsewhere on the board
/VIN_Sense: J105.19; also elsewhere on the board
/V_{FWD}: J105.23; also elsewhere on the board
/~5V5_FLT: J105.5; also elsewhere on the board
/~PCF_INT: J105.6; also elsewhere on the board
/~PSU_FAULT: J105.21; also elsewhere on the board
/~RX_{EN}: J105.29, J107.16, J108.16
GND: J101.1, J102.2 (Ext), J103.2 (Ext), J104.2 (Ext), J105.4, J105.7, J105.9, J105.13, J105.16, J105.20, J105.32, J105.34, J105.35, J105.36, J105.39, J105.43, J105.46, J105.48, J106.2 (Ext), J107.1, J107.3, J107.13, J107.14, J107.15, J107.19, J107.20, J108.1, J108.3, J108.13, J108.14, J108.19, J108.20, J109.2 (Ext), J110.2 (Ext), J111.6, J112.2, J112.3, J113.2, J113.3, J114.2 (Ext), J115.2 (Ext), TP101.1, TP102.1, TP103.1, TP104.1; also elsewhere on the board
unnamed: J104.1 (In), R101.1

Notes on the sheet:
1st LO ~400 MHz
DIGITAL
Control head connector
Power Switch Connector
LO1 Module connector
DNP when using on board VCTCXOs
LNB
Fref IN
2.4 GHz TX PA
ANALOG
TRX
IO Port
LO2 Module connector
Ext. RX
DC 10-16 V
~-23 dB sample
1st LO ~2000 MHz
0 + DNP LO modules jumpers for VCTCXOs

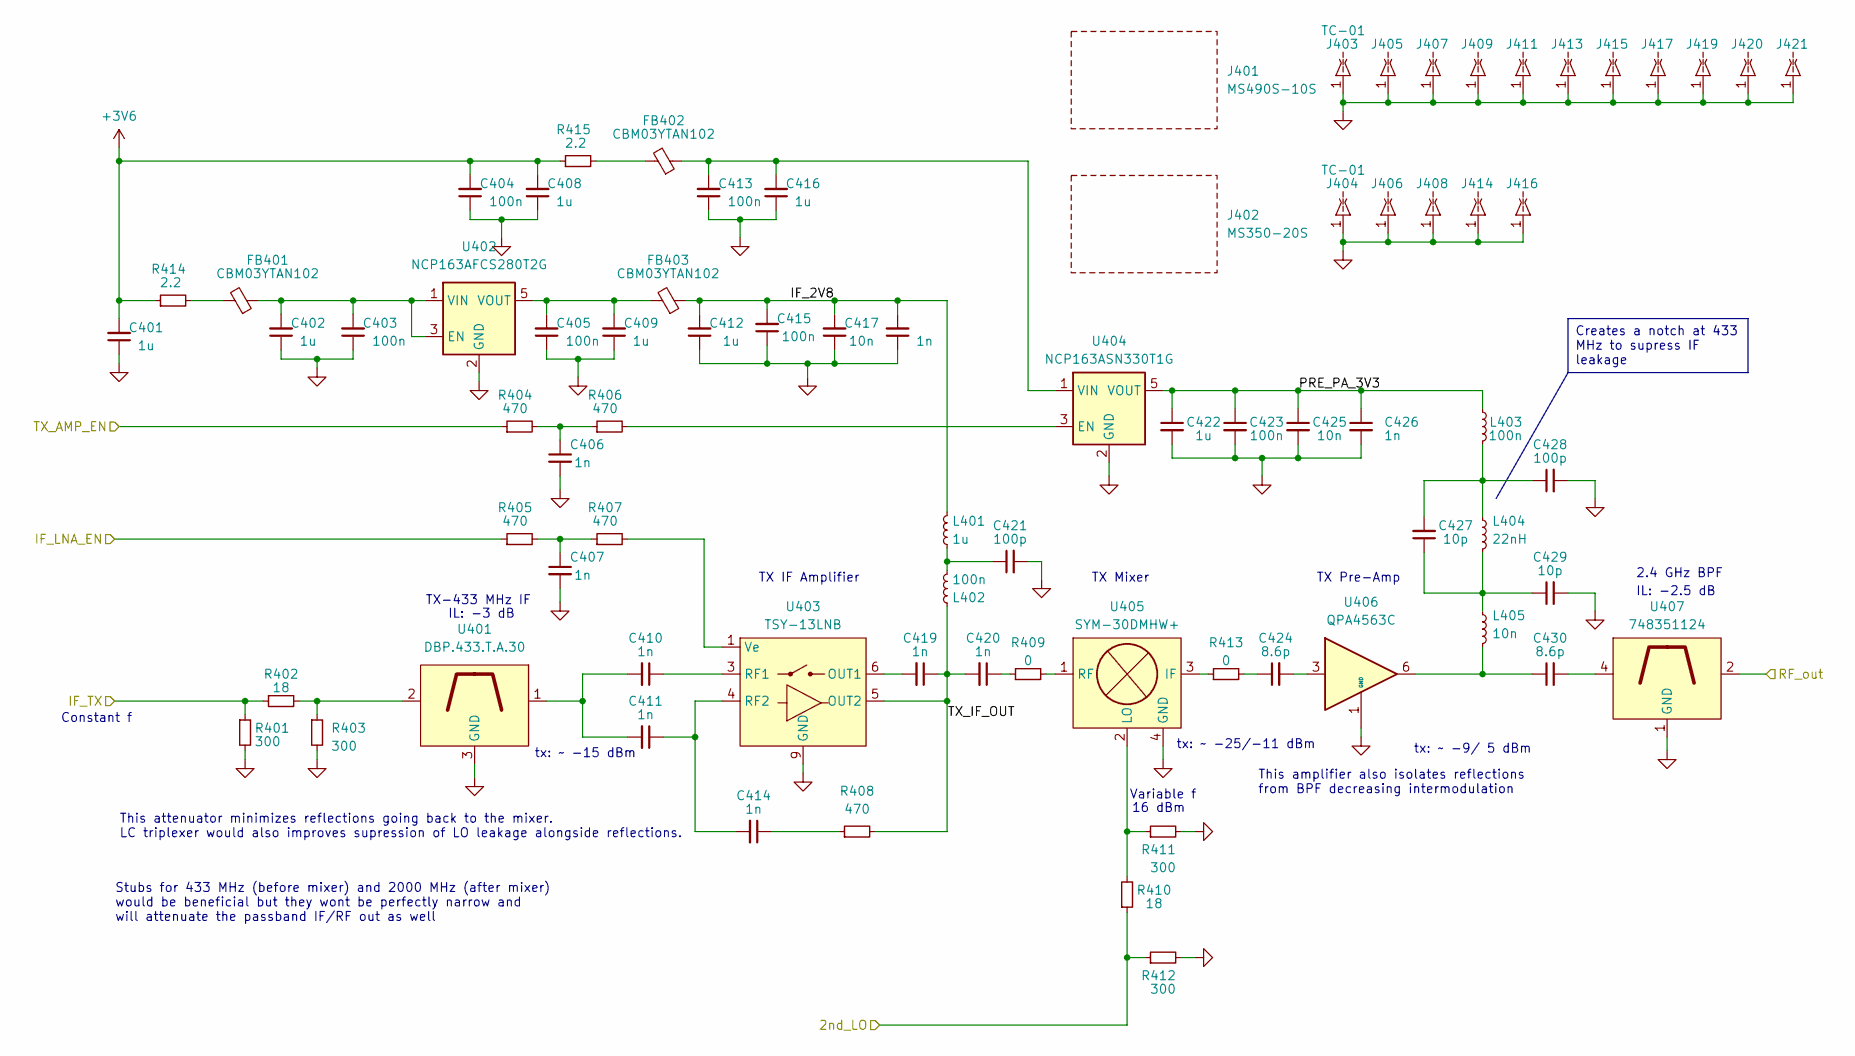
[picture p49: schematic TX_mixer.kicad_sch, Presto transverter]

Parts:
C401, C402, C408, C409, C412, C416, C422: 1u; C_0603_1608Metric_Pad1.08x0.95mm_HandSolder
C403, C404, C405, C413, C415, C423: 100n; C_0603_1608Metric_Pad1.08x0.95mm_HandSolder
C406, C407, C410, C411, C414, C418, C419, C420, C426: 1n; C_0603_1608Metric_Pad1.08x0.95mm_HandSolder
C417, C425: 10n; C_0603_1608Metric_Pad1.08x0.95mm_HandSolder
C421, C428: 100p; C_0603_1608Metric_Pad1.08x0.95mm_HandSolder
C424, C430: 8.6p; C_0603_1608Metric_Pad1.08x0.95mm_HandSolder
C427, C429: 10p; C_0603_1608Metric_Pad1.08x0.95mm_HandSolder
FB401, FB402, FB403: CBM03YTAN102; L_0603_1608Metric_Pad1.05x0.95mm_HandSolder
J401: MS490S-10S; MS490_Shield
J402: MS350-20S; MS323-30S-NS
J403, J404, J419, J421: TC-01; TC-01_CLIP_LeaderTech_half
J405, J406, J407, J408, J409, J411, J413, J414, J415, J416, J417, J420: TC-01; TC-01_CLIP_LeaderTech
L401: 1u; L_0805_2012Metric_Pad1.05x1.20mm_HandSolder
L402, L403: 100n; L_0603_1608Metric_Pad1.05x0.95mm_HandSolder
L404: 22nH; L_0603_1608Metric_Pad1.05x0.95mm_HandSolder
L405: 10n; L_0603_1608Metric_Pad1.05x0.95mm_HandSolder
R401, R403, R411, R412: 300; R_0603_1608Metric_Pad0.98x0.95mm_HandSolder
R402, R410: 18; R_0603_1608Metric_Pad0.98x0.95mm_HandSolder
R404, R406, R408: 470; R_0603_1608Metric_Pad0.98x0.95mm_HandSolder
R405, R407: 470; R_0402_1005Metric_Pad0.72x0.64mm_HandSolder
R409, R413: 0; R_1206_3216Metric_Pad1.30x1.75mm_HandSolder
R414, R415: 2.2; R_0603_1608Metric_Pad0.98x0.95mm_HandSolder
U401: DBP.433.T.A.30; TAOGLAS_DBP_433
U402: NCP163AFCS280T2G; SOT-23-5
U403: TSY-13LNB; MiniCircuits_MC163_TSY13LNB
U404: NCP163ASN330T1G; SOT-23-5
U405: SYM-30DMHW+; SYM-18H+
U406: QPA4563C; SOT-363_SC-70-6_Handsoldering
U407: 748351124; Wurth_BPF_2400_nr748351124

Connections:
3V6: C401.2, C404.2, C408.2, R414.1, R415.1; also elsewhere on the board
/IF_LNA_EN: R405.1; also elsewhere on the board
/Input_&_IF_Mixer/IF_TX: R401.1, R402.1; also elsewhere on the board
/Output_PA/RF_IN: U407.2; also elsewhere on the board
/TX_PA_EN: R404.1; also elsewhere on the board
/TX_mixer/2nd_LO: R410.1, R412.1; also elsewhere on the board
/TX_mixer/IF_2V8: C412.2, C415.2, C417.2, C418.2, FB403.1, L401.1
/TX_mixer/PRE_PA_3V3: C422.1, C423.1, C425.1, C426.1, L403.1, U404.5 (VOUT)
/TX_mixer/TX_IF_OUT: C419.1, C420.2, L402.2, R408.2, U403.5 (OUT2)
GND: C401.1, C402.1, C403.1, C404.1, C405.1, C406.2, C407.2, C408.1, C409.1, C412.1, C413.1, C415.1, C416.1, C417.1, C418.1, C421.2, C422.2, C423.2, C425.2, C426.2, C428.2, C429.2, J403.1, J404.1, J405.1, J406.1, J407.1, J408.1, J409.1, J411.1, J413.1, J414.1, J415.1, J416.1, J417.1, J419.1, J420.1, J421.1, R401.2, R403.2, R411.2, R412.2, U401.3 (GND), U402.2 (GND), U403.2 (GND), U403.7 (GND), U403.8 (GND), U403.9 (GND), U404.2 (GND), U405.4 (GND), U405.5 (GND), U405.6 (GND), U406.1 (GND), U406.2 (GND), U406.4 (GND), U406.5 (GND), U407.1 (GND), U407.3 (GND); also elsewhere on the board
unnamed: C406.1, R404.2, R406.1
unnamed: C407.1, R405.2, R407.1
unnamed: C410.2, C411.2, U401.1
unnamed: C414.1, R408.1
unnamed: C420.1, R409.1
unnamed: C421.1, L401.2, L402.1
unnamed: C424.1, R413.2
unnamed: C424.2, U406.3
unnamed: C427.1, C429.1, L404.2, L405.1
unnamed: C427.2, C428.1, L403.2, L404.1
unnamed: C430.1, L405.2, U406.6
unnamed: C430.2, U407.4
unnamed: FB401.2, R414.2
unnamed: FB402.2, R415.2
unnamed: R402.2, R403.1, U401.2
unnamed: C402.2, C403.2, FB401.1, U402.1 (VIN), U402.3 (EN)
unnamed: C405.2, C409.2, FB403.2, U402.5 (VOUT)
unnamed: C419.2, U403.6 (OUT1)
unnamed: C410.1, U403.3 (RF1)
unnamed: C411.1, C414.2, U403.4 (RF2)
unnamed: R407.2, U403.1 (Ve)
unnamed: R406.2, U404.3 (EN)
unnamed: C413.2, C416.2, FB402.1, U404.1 (VIN)
unnamed: R413.1, U405.3 (IF)
unnamed: R410.2, R411.1, U405.2 (LO)
unnamed: R409.2, U405.1 (RF)

Notes on the sheet:
Variable f
This amplifier also isolates reflections from BPF decreasing intermodulation
2.4 GHz BPF
TX-433 MHz IF
TX Mixer
16 dBm
This attenuator minimizes reflections going back to the mixer. LC triplexer would also improves supression of LO leakage alongside reflections.
tx: ~ -15 dBm
IL: -3 dB
IL: -2.5 dB
Stubs for 433 MHz (before mixer) and 2000 MHz (after mixer) would be beneficial but they wont be perfectly narrow and will attenuate the passband IF/RF out as well
TX Pre-Amp
tx: ~ -9/ 5 dBm
Constant f
tx: ~ -25/-11 dBm
TX IF Amplifier
Creates a notch at 433 MHz to supress IF leakage

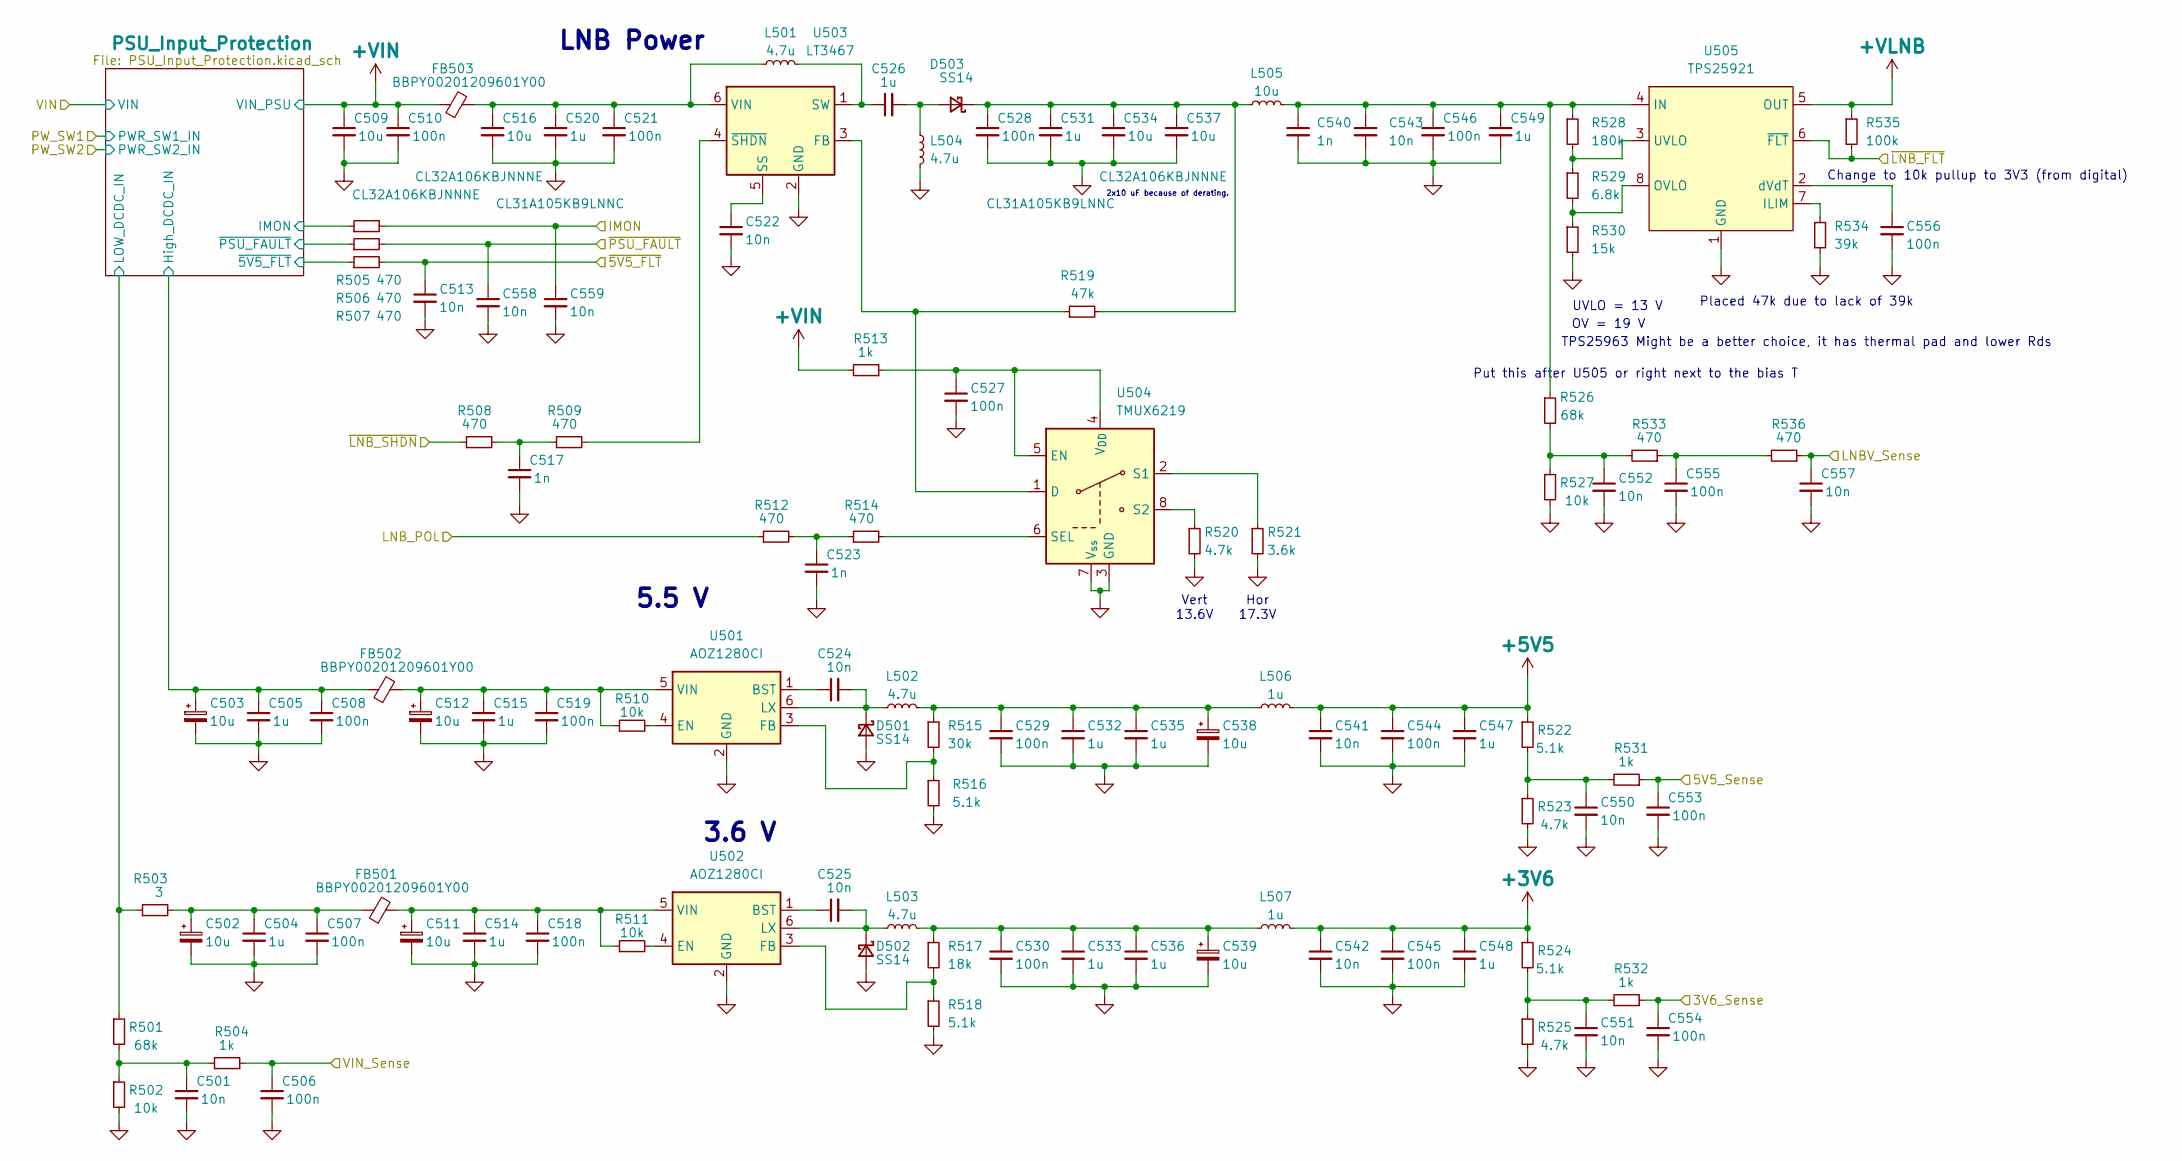
[picture p50: schematic PSU_LNB.kicad_sch, Presto transverter]

Parts:
C501, C524, C525, C542, C550, C551, C552: 10n; C_0603_1608Metric_Pad1.08x0.95mm_HandSolder
C502, C503, C511, C512, C538, C539: 10u; C_1206_3216Metric_Pad1.33x1.80mm_HandSolder
C504, C505, C514, C515, C526, C532, C533, C535, C536, C547, C548: 1u; C_0805_2012Metric_Pad1.18x1.45mm_HandSolder
C506, C545, C553, C554, C555: 100n; C_0603_1608Metric_Pad1.08x0.95mm_HandSolder
C507, C508, C510, C518, C519, C521, C527, C528, C529, C530, C544, C546, C556: 100n; C_0805_2012Metric_Pad1.18x1.45mm_HandSolder
C509, C516, C534, C537: 10u; C_1210_3225Metric_Pad1.33x2.70mm_HandSolder
C513, C557, C558, C559: 10n; C_0402_1005Metric_Pad0.74x0.62mm_HandSolder
C517, C523: 1n; C_0603_1608Metric_Pad1.08x0.95mm_HandSolder
C520, C531, C549: 1u; C_1206_3216Metric_Pad1.33x1.80mm_HandSolder
C522, C541, C543: 10n; C_0805_2012Metric_Pad1.18x1.45mm_HandSolder
C540: 1n; C_0805_2012Metric_Pad1.18x1.45mm_HandSolder
D501, D502, D503: SS14; D_SMA
FB501, FB502, FB503: BBPY00201209601Y00; L_0805_2012Metric_Pad1.05x1.20mm_HandSolder
L501, L502, L503, L504: 4.7u; L_6.3x6.3_H3
L505: 10u; LED_0805_2012Metric
L506, L507: 1u; LED_0805_2012Metric
R501, R526: 68k; R_0805_2012Metric_Pad1.20x1.40mm_HandSolder
R502, R527: 10k; R_0805_2012Metric_Pad1.20x1.40mm_HandSolder
R503: 3; R_1206_3216Metric_Pad1.30x1.75mm_HandSolder
R504, R513, R531, R532: 1k; R_0603_1608Metric_Pad0.98x0.95mm_HandSolder
R505, R506, R507, R536: 470; R_0402_1005Metric_Pad0.72x0.64mm_HandSolder
R508, R509, R512, R514, R533: 470; R_0603_1608Metric_Pad0.98x0.95mm_HandSolder
R510, R511: 10k; R_0603_1608Metric_Pad0.98x0.95mm_HandSolder
R515: 30k; R_0603_1608Metric_Pad0.98x0.95mm_HandSolder
R516, R518, R522, R524: 5.1k; R_0603_1608Metric_Pad0.98x0.95mm_HandSolder
R517: 18k; R_0603_1608Metric_Pad0.98x0.95mm_HandSolder
R519: 47k; R_0603_1608Metric_Pad0.98x0.95mm_HandSolder
R520, R523, R525: 4.7k; R_0603_1608Metric_Pad0.98x0.95mm_HandSolder
R521: 3.6k; R_0603_1608Metric_Pad0.98x0.95mm_HandSolder
R528: 180k; R_0805_2012Metric_Pad1.20x1.40mm_HandSolder
R529: 6.8k; R_0805_2012Metric_Pad1.20x1.40mm_HandSolder
R530: 15k; R_0805_2012Metric_Pad1.20x1.40mm_HandSolder
R534: 39k; R_0603_1608Metric_Pad0.98x0.95mm_HandSolder
R535: 100k; R_0603_1608Metric_Pad0.98x0.95mm_HandSolder
U501, U502: AOZ1280CI; SOT-23-6
U503: LT3467; TSOT-23-6_HandSoldering
U504: TMUX6219; VSSOP8_3x3mm
U505: TPS25921; SOIC8_EP_3.9x4.9P1.27

Connections:
3V6: C542.1, C545.1, C548.1, L507.2, R524.1; also elsewhere on the board
5V5: C541.1, C544.1, C547.1, L506.2, R522.1; also elsewhere on the board
+VIN: C509.1, C510.1, FB503.1, R501.1, R503.1, R513.2; also elsewhere on the board
+VLNB: R535.1, U505.5 (OUT); also elsewhere on the board
/3V6_Sense: C554.1, R532.1; also elsewhere on the board
/5V5_Sense: C553.1, R531.1; also elsewhere on the board
/IMON: C559.1, R505.2; also elsewhere on the board
/LNBV_Sense: C557.1, R536.1; also elsewhere on the board
/LNB_POL: R512.1; also elsewhere on the board
/PSU_LNB/PSU_Input_Protection/High_DCDC_IN: C503.1, C505.1, C508.1, FB502.1; also elsewhere on the board
/PSU_LNB/PSU_Input_Protection/IMON: R505.1; also elsewhere on the board
/PSU_LNB/PSU_Input_Protection/~5V5_FLT: R507.1; also elsewhere on the board
/PSU_LNB/PSU_Input_Protection/~PSU_FAULT: R506.1; also elsewhere on the board
/VIN_Sense: C506.1, R504.1; also elsewhere on the board
/~5V5_FLT: C513.1, R507.2; also elsewhere on the board
/~LNB_FLT: R535.2, U505.6 (~FLT); also elsewhere on the board
/~LNB_SHDN: R508.1; also elsewhere on the board
/~PSU_FAULT: C558.1, R506.2; also elsewhere on the board
GND: C501.2, C502.2, C503.2, C504.2, C505.2, C506.2, C507.2, C508.2, C509.2, C510.2, C511.2, C512.2, C513.2, C514.2, C515.2, C516.2, C517.2, C518.2, C519.2, C520.2, C521.2, C522.2, C523.2, C527.2, C528.2, C529.2, C530.2, C531.2, C532.2, C533.2, C534.2, C535.2, C536.2, C537.2, C538.2, C539.2, C540.2, C541.2, C542.2, C543.2, C544.2, C545.2, C546.2, C547.2, C548.2, C549.2, C550.2, C551.2, C552.2, C553.2, C554.2, C555.2, C556.2, C557.2, C558.2, C559.2, D501.2 (A), D502.2 (A), L504.2, R502.2, R516.2, R518.2, R520.2, R521.2, R523.2, R525.2, R527.2, R530.2, R534.2, U501.2 (GND), U502.2 (GND), U503.2 (GND), U504.3 (GND), U504.7 (V_{ss}), U505.1 (GND), U505.9 (GND); also elsewhere on the board
unnamed: C501.1, R501.2, R502.1, R504.2
unnamed: C502.1, C504.1, C507.1, FB501.1, R503.2
unnamed: C517.1, R508.2, R509.1
unnamed: C523.1, R512.2, R514.1
unnamed: C529.1, C532.1, C535.1, C538.1, L502.2, L506.1, R515.1
unnamed: C530.1, C533.1, C536.1, C539.1, L503.2, L507.1, R517.1
unnamed: C550.1, R522.2, R523.1, R531.2
unnamed: C551.1, R524.2, R525.1, R532.2
unnamed: C552.1, R526.2, R527.1, R533.2
unnamed: C555.1, R533.1, R536.2
unnamed: C524.2, D501.1 (K), L502.1, U501.6 (LX)
unnamed: C525.2, D502.1 (K), L503.1, U502.6 (LX)
unnamed: C526.2, D503.2 (A), L504.1
unnamed: C528.1, C531.1, C534.1, C537.1, D503.1 (K), L505.1, R519.2
unnamed: C524.1, U501.1 (BST)
unnamed: R510.2, U501.4 (EN)
unnamed: R515.2, R516.1, U501.3 (FB)
unnamed: C512.1, C515.1, C519.1, FB502.2, R510.1, U501.5 (VIN)
unnamed: C525.1, U502.1 (BST)
unnamed: R511.2, U502.4 (EN)
unnamed: R517.2, R518.1, U502.3 (FB)
unnamed: C511.1, C514.1, C518.1, FB501.2, R511.1, U502.5 (VIN)
unnamed: R519.1, U503.3 (FB), U504.1 (D)
unnamed: C522.1, U503.5 (SS)
unnamed: C526.1, L501.2, U503.1 (SW)
unnamed: C516.1, C520.1, C521.1, FB503.2, L501.1, U503.6 (VIN)
unnamed: R509.2, U503.4 (~SHDN)
unnamed: C527.1, R513.1, U504.4 (V_{DD}), U504.5 (EN)
unnamed: R521.1, U504.2 (S1)
unnamed: R520.1, U504.8 (S2)
unnamed: R514.2, U504.6 (SEL)
unnamed: R534.1, U505.7 (ILIM)
unnamed: C540.1, C543.1, C546.1, C549.1, L505.2, R526.1, R528.1, U505.4 (IN)
unnamed: R529.2, R530.1, U505.8 (OVLO)
unnamed: R528.2, R529.1, U505.3 (UVLO)
unnamed: C556.1, U505.2 (dVdT)

Notes on the sheet:
5.5 V
TPS25963 Might be a better choice, it has thermal pad and lower Rds
Placed 47k due to lack of 39k
Vert 13.6V
Put this after U505 or right next to the bias T
UVLO = 13 V
Hor 17.3V
2x10 uF because of derating.
LNB Power
3.6 V
Change to 10k pullup to 3V3 (from digital)
OV = 19 V
