SP6GK/Presto-Transverter/ECAD/KiCad_0006_PrestoMB_rev01a/0006_PrestoMB.kicad_pcb

## KiCad design ECAD/KiCad_0006_PrestoMB_rev01a/0006_PrestoMB.kicad_pcb (continued)

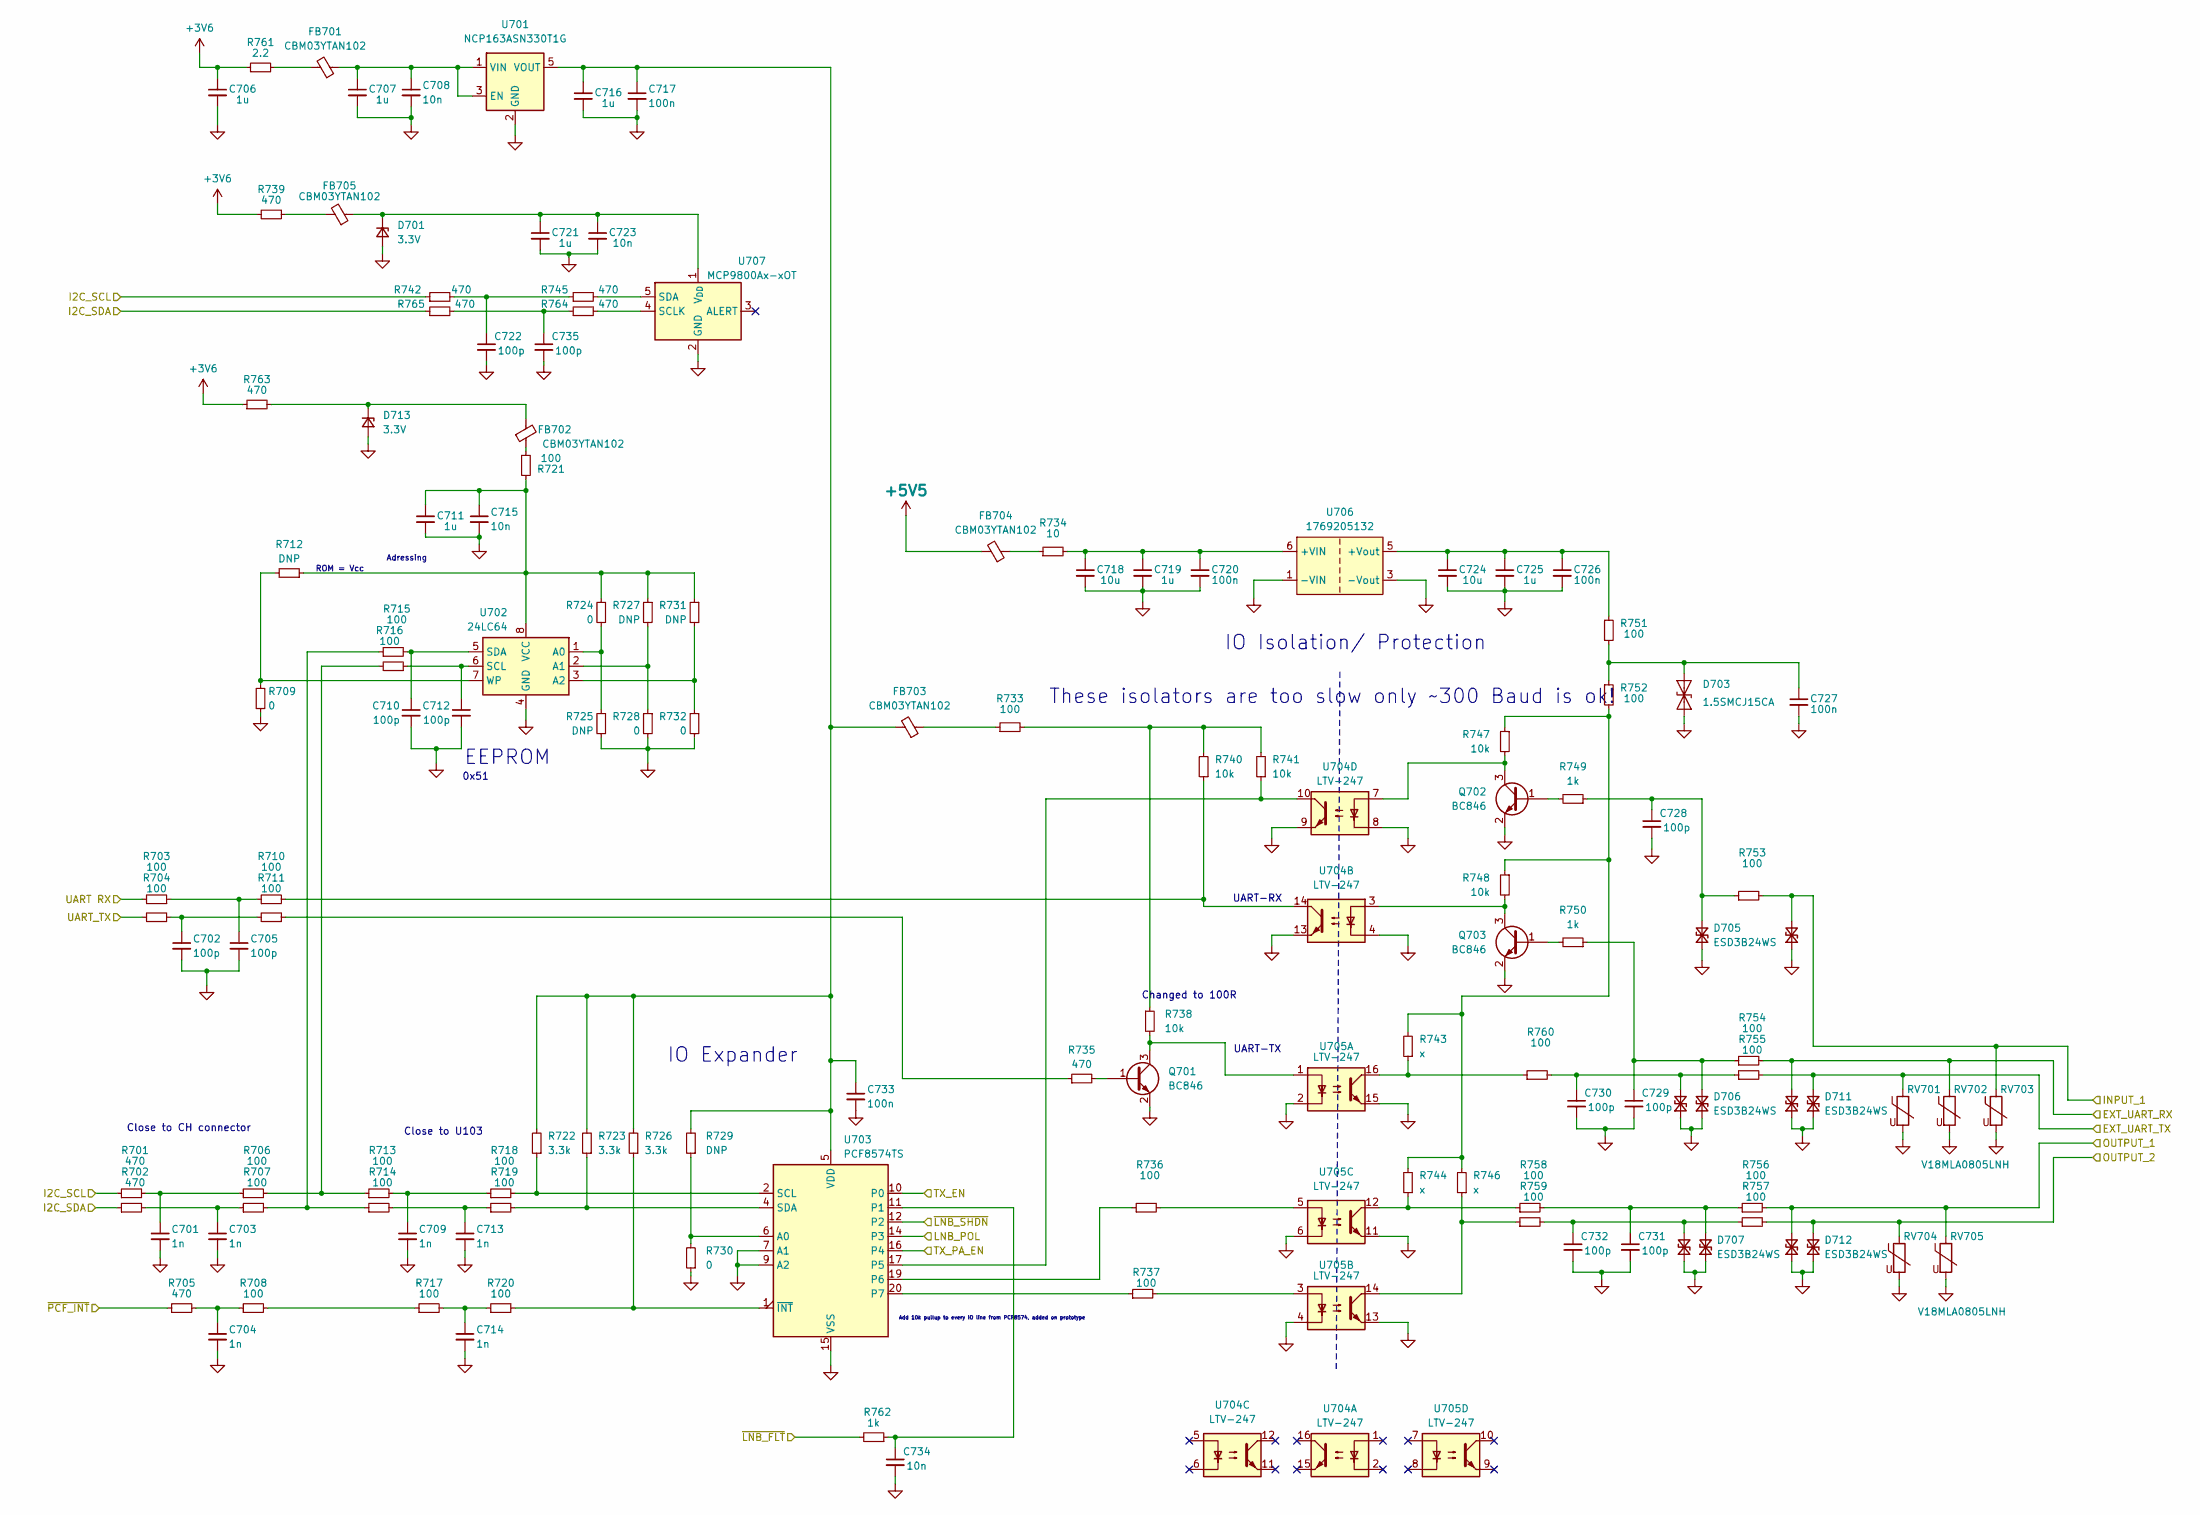
[picture p51: schematic Digital_IO.kicad_sch, Presto transverter]

Parts:
C701, C703, C704, C709, C713, C714: 1n; C_0402_1005Metric_Pad0.74x0.62mm_HandSolder
C702, C705, C710, C712, C722, C735: 100p; C_0402_1005Metric_Pad0.74x0.62mm_HandSolder
C706, C707, C711, C716, C719, C721, C725: 1u; C_0603_1608Metric_Pad1.08x0.95mm_HandSolder
C708, C715, C723: 10n; C_0603_1608Metric_Pad1.08x0.95mm_HandSolder
C717, C720, C726, C727, C733: 100n; C_0603_1608Metric_Pad1.08x0.95mm_HandSolder
C718, C724: 10u; C_1206_3216Metric_Pad1.33x1.80mm_HandSolder
C728, C729, C730, C731, C732: 100p; R_0603_1608Metric
C734: 10n; C_0402_1005Metric_Pad0.74x0.62mm_HandSolder
D701, D713: 3.3V; D_SOD-123F
D702, D704, D705, D706, D707, D708, D709, D710, D711, D712: ESD3B24WS; D_SOD-323_HandSoldering
D703: 1.5SMCJ15CA; D_SMA
FB701, FB702, FB703, FB704, FB705: CBM03YTAN102; L_0603_1608Metric_Pad1.05x0.95mm_HandSolder
Q701, Q702, Q703: BC846; SOT-23
R701, R702, R705, R742, R745, R764, R765: 470; R_0402_1005Metric_Pad0.72x0.64mm_HandSolder
R703, R704, R706, R707, R708, R710, R711, R713, R714, R715, R716, R717, R718, R719, R720: 100; R_0402_1005Metric_Pad0.72x0.64mm_HandSolder
R709, R730: 0; R_0603_1608Metric_Pad0.98x0.95mm_HandSolder
R712, R729: DNP; R_0603_1608Metric_Pad0.98x0.95mm_HandSolder
R721, R733, R736, R737, R752, R753, R754, R755, R756, R757, R758, R759, R760: 100; R_0603_1608Metric_Pad0.98x0.95mm_HandSolder
R722, R723, R726: 3.3k; R_0603_1608Metric_Pad0.98x0.95mm_HandSolder
R724, R728, R732: 0; R_0805_2012Metric
R725, R727, R731: DNP; R_0805_2012Metric
R734: 10; R_0603_1608Metric_Pad0.98x0.95mm_HandSolder
R735, R739: 470; R_0603_1608Metric_Pad0.98x0.95mm_HandSolder
R738, R747, R748: 10k; R_0603_1608Metric_Pad0.98x0.95mm_HandSolder
R740, R741: 10k; R_0603_1608Metric
R743, R744, R746: x; R_0603_1608Metric
R749, R750: 1k; R_0603_1608Metric_Pad0.98x0.95mm_HandSolder
R751: 100; R_0805_2012Metric_Pad1.20x1.40mm_HandSolder
R761: 2.2; R_0603_1608Metric_Pad0.98x0.95mm_HandSolder
R762: 1k; R_0402_1005Metric_Pad0.72x0.64mm_HandSolder
R763: 470; R_0805_2012Metric_Pad1.20x1.40mm_HandSolder
RV701, RV702, RV703, RV704, RV705: V18MLA0805LNH; R_0805_2012Metric_Pad1.20x1.40mm_HandSolder
U701: NCP163ASN330T1G; SOT-23-5
U702: 24LC64; SOIC-8_3.9x4.9mm_P1.27mm
U703: PCF8574TS; SSOP-20_4.4x6.5mm_P0.65mm
U704, U705: LTV-247; SOP-16_4.4x10.4mm_P1.27mm
U706: 1769205132
U707: MCP9800Ax-xOT; SOT-23-5

Connections:
3V6: C706.1, R739.1, R761.1, R763.1; also elsewhere on the board
5V5: FB704.2; also elsewhere on the board
/Digital/EXT_UART_RX: D709.2 (A2), R754.2, RV702.1; also elsewhere on the board
/Digital/EXT_UART_TX: D711.2 (A2), R755.2, RV701.1; also elsewhere on the board
/Digital/INPUT_1: D708.2 (A2), R753.2, RV703.1; also elsewhere on the board
/Digital/OUTPUT_1: D710.2 (A2), R756.2, RV705.1; also elsewhere on the board
/Digital/OUTPUT_2: D712.2 (A2), R757.2, RV704.1; also elsewhere on the board
/I2C_SCL: R701.1, R742.1; also elsewhere on the board
/I2C_SDA: R702.1, R765.1; also elsewhere on the board
/LNB_POL: U703.12 (P2); also elsewhere on the board
/TX_EN: U703.10 (P0); also elsewhere on the board
/TX_PA_EN: U703.16 (P4); also elsewhere on the board
/UART RX: R703.2; also elsewhere on the board
/UART_TX: R704.2; also elsewhere on the board
/~LNB_FLT: R762.2; also elsewhere on the board
/~LNB_SHDN: U703.14 (P3); also elsewhere on the board
/~PCF_INT: R705.1; also elsewhere on the board
GND: C701.2, C702.2, C703.2, C704.2, C705.2, C706.2, C707.2, C708.2, C709.2, C710.2, C711.2, C712.2, C713.2, C714.2, C715.2, C716.2, C717.2, C718.2, C719.2, C720.2, C721.2, C722.2, C723.2, C724.2, C725.2, C726.2, C727.2, C728.2, C729.2, C730.2, C731.2, C732.2, C733.2, C734.2, C735.2, D701.2 (A), D702.1 (A1), D703.2 (A2), D704.1 (A1), D705.1 (A1), D706.1 (A1), D707.1 (A1), D708.1 (A1), D709.1 (A1), D710.1 (A1), D711.1 (A1), D712.1 (A1), D713.2 (A), Q701.2 (E), Q702.2 (E), Q703.2 (E), R709.2, R725.2, R728.2, R730.1, R732.2, RV701.2, RV702.2, RV703.2, RV704.2, RV705.2, U701.2 (GND), U702.4 (GND), U703.7 (A1), U703.9 (A2), U703.15 (VSS), U704.4, U704.8, U704.9, U704.13, U705.2, U705.4, U705.6, U705.11, U705.13, U705.15, U706.1 (-VIN), U706.2 (-VIN), U706.3 (-Vout), U706.4 (-Vout), U707.2 (GND); also elsewhere on the board
unnamed: C701.1, R701.2, R706.1
unnamed: C702.1, R704.1, R711.2
unnamed: C703.1, R702.2, R707.1
unnamed: C704.1, R705.2, R708.1
unnamed: C705.1, R703.1, R710.1
unnamed: C709.1, R713.2, R718.1
unnamed: C713.1, R714.2, R719.1
unnamed: C714.1, R717.2, R720.1
unnamed: C718.1, C719.1, C720.1, R734.2, U706.6 (+VIN), U706.7 (+VIN)
unnamed: C722.1, R742.2, R745.1
unnamed: C735.1, R764.1, R765.2
unnamed: C721.1, C723.1, D701.1 (K), FB705.1, U707.1 (V_{DD})
unnamed: C730.1, D702.2 (A2), R755.1, R760.2
unnamed: C727.1, D703.1 (A1), R751.2, R752.1
unnamed: C732.1, D704.2 (A2), R757.1, R759.2
unnamed: C728.1, D705.2 (A2), R749.1, R753.1
unnamed: C729.1, D706.2 (A2), R750.1, R754.1
unnamed: C731.1, D707.2 (A2), R756.1, R758.2
unnamed: D713.1 (K), FB702.2, R763.2
unnamed: FB701.2, R761.2
unnamed: FB702.1, R721.1
unnamed: FB703.1, R733.1
unnamed: FB704.1, R734.1
unnamed: FB705.2, R739.2
unnamed: Q701.1 (B), R735.2
unnamed: Q701.3 (C), R738.2, U705.1
unnamed: Q702.1 (B), R749.2
unnamed: Q702.3 (C), R747.2, U704.7
unnamed: Q703.1 (B), R750.2
unnamed: Q703.3 (C), R748.2, U704.3
unnamed: R706.2, R713.1, R716.2
unnamed: R707.2, R714.1, R715.1
unnamed: R708.2, R717.1
unnamed: R710.2, R740.1, U704.14
unnamed: R711.1, R735.1
unnamed: R733.2, R738.1, R740.2, R741.2
unnamed: R736.2, U705.5
unnamed: R737.2, U705.3
unnamed: R743.1, R760.1, U705.16
unnamed: R743.2, R744.2, R746.2, R747.1, R748.1, R752.2
unnamed: R744.1, R758.1, U705.12
unnamed: R746.1, R759.1, U705.14
unnamed: C707.1, C708.1, FB701.1, U701.1 (VIN), U701.3 (EN)
unnamed: C716.1, C717.1, C733.1, FB703.2, R722.2, R723.2, R726.2, R729.2, U701.5 (VOUT), U703.5 (VDD)
unnamed: R724.2, R725.1, U702.1 (A0)
unnamed: R727.2, R728.1, U702.2 (A1)
unnamed: R731.2, R732.1, U702.3 (A2)
unnamed: C712.1, R716.1, U702.6 (SCL)
unnamed: C710.1, R715.2, U702.5 (SDA)
unnamed: C711.1, C715.1, R712.1, R721.2, R724.1, R727.1, R731.1, U702.8 (VCC)
unnamed: R709.1, R712.2, U702.7 (WP)
unnamed: R729.1, R730.2, U703.6 (A0)
unnamed: C734.1, R762.1, U703.11 (P1)
unnamed: R741.1, U703.17 (P5), U704.10
unnamed: R736.1, U703.19 (P6)
unnamed: R737.1, U703.20 (P7)
unnamed: R718.2, R722.1, U703.2 (SCL)
unnamed: R719.2, R723.1, U703.4 (SDA)
unnamed: R720.2, R726.1, U703.1 (~INT)
unnamed: C724.1, C725.1, C726.1, R751.1, U706.5 (+Vout)
unnamed: R764.2, U707.4 (SCLK)
unnamed: R745.2, U707.5 (SDA)

Notes on the sheet:
ROM = Vcc
IO Isolation/ Protection
0x51
Add 10k pullup to every IO line from PCF8574, added on prototype
Changed to 100R
IO Expander
UART-TX
UART-RX
EEPROM
Adressing
Close to CH connector
Close to U103
These isolators are too slow only ~300 Baud is ok!

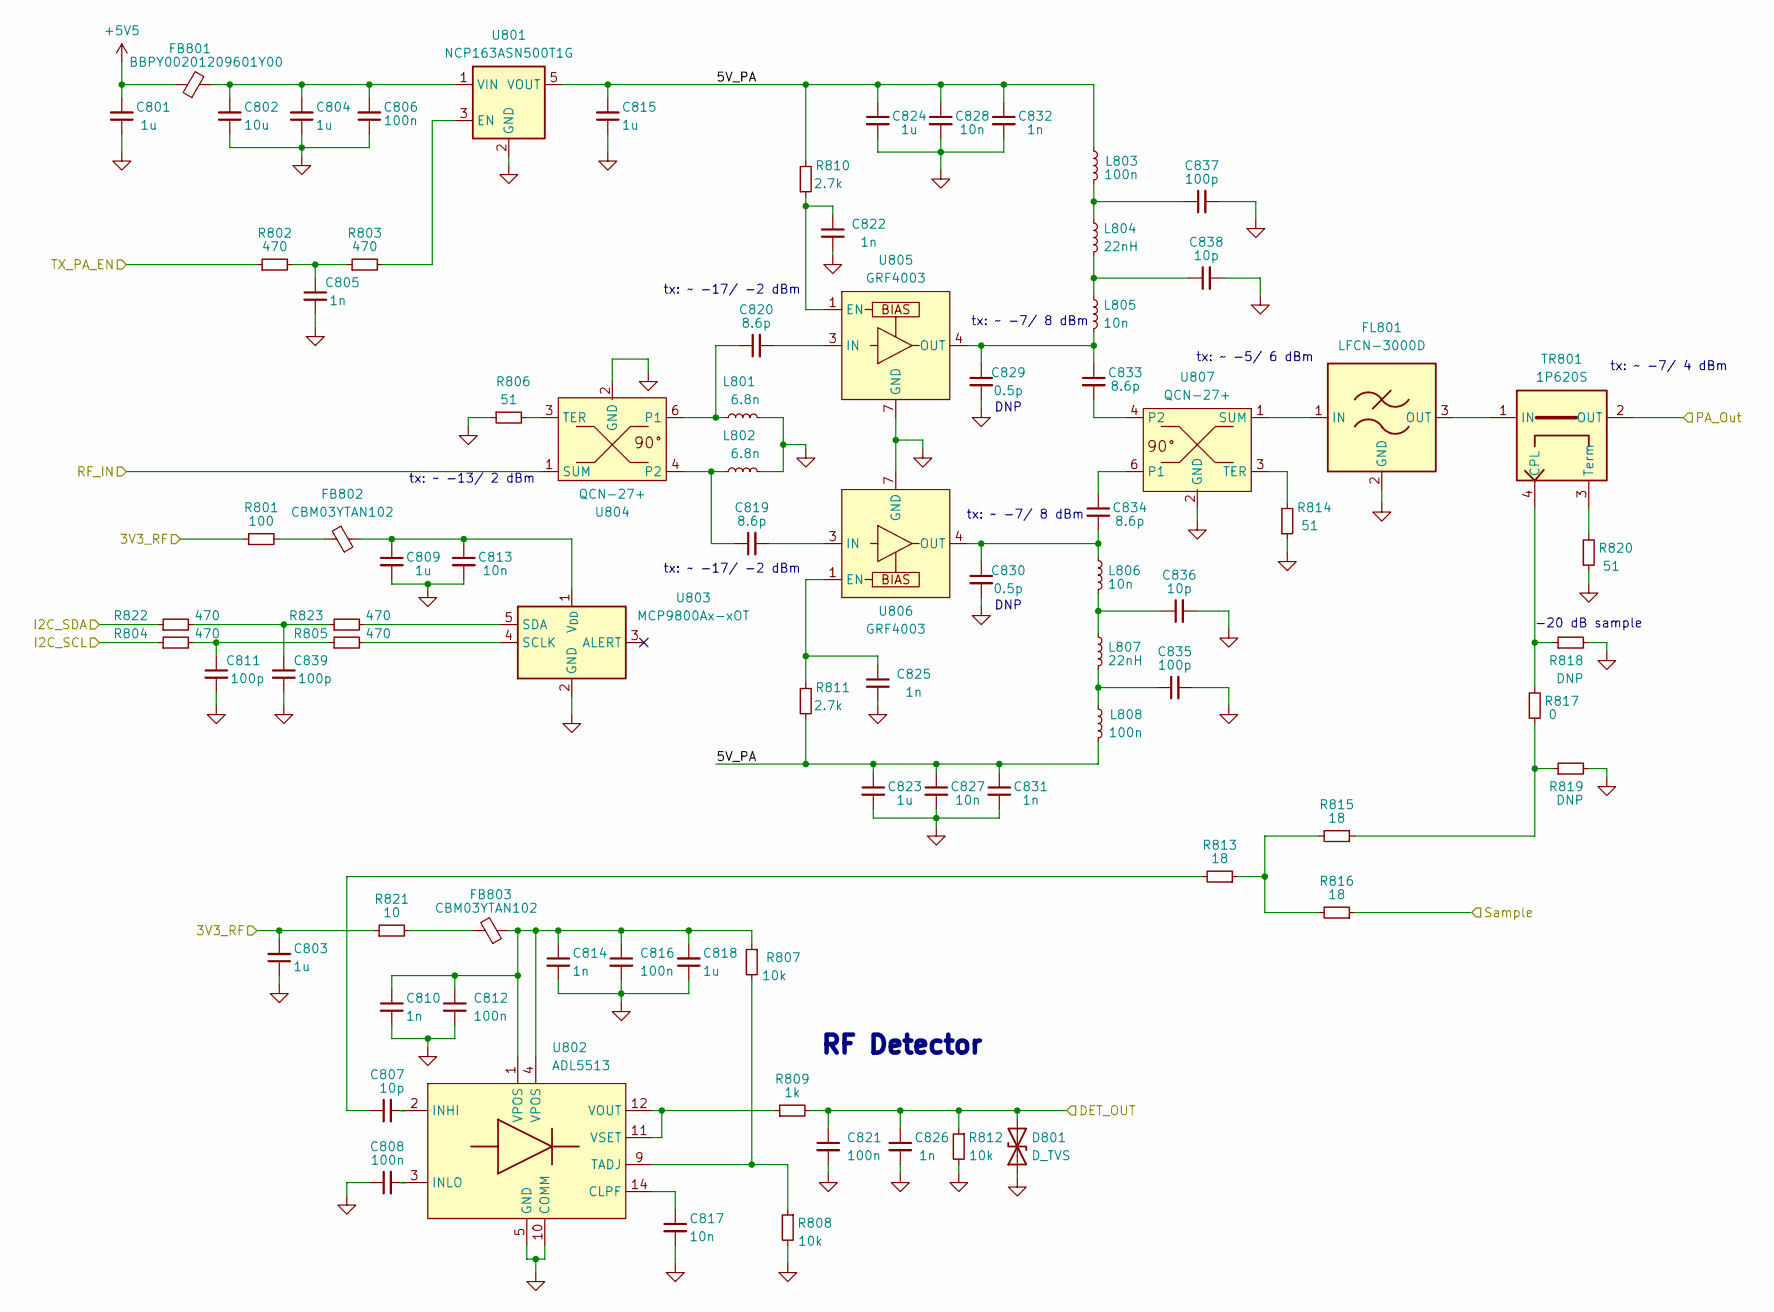
[picture p52: schematic Output_PA.kicad_sch, Presto transverter]

Parts:
C801, C803, C804, C809, C815, C818, C823, C824: 1u; C_0603_1608Metric_Pad1.08x0.95mm_HandSolder
C802: 10u; LED_0805_2012Metric
C805: 1n; R_0603_1608Metric
C806, C808, C812, C816, C821: 100n; C_0603_1608Metric_Pad1.08x0.95mm_HandSolder
C807, C836, C838: 10p; C_0603_1608Metric_Pad1.08x0.95mm_HandSolder
C810, C814, C822, C825, C826, C831, C832: 1n; C_0603_1608Metric_Pad1.08x0.95mm_HandSolder
C811, C839: 100p; C_0402_1005Metric_Pad0.74x0.62mm_HandSolder
C813, C817, C827, C828: 10n; C_0603_1608Metric_Pad1.08x0.95mm_HandSolder
C819, C820, C833, C834: 8.6p; C_0603_1608Metric_Pad1.08x0.95mm_HandSolder
C829, C830: 0.5p; C_0603_1608Metric_Pad1.08x0.95mm_HandSolder
C835, C837: 100p; C_0603_1608Metric_Pad1.08x0.95mm_HandSolder
D801: D_TVS; D_SOD-323
FB801: BBPY00201209601Y00; L_0805_2012Metric_Pad1.05x1.20mm_HandSolder
FB802, FB803: CBM03YTAN102; L_0603_1608Metric_Pad1.05x0.95mm_HandSolder
FL801: LFCN-3000D; Filter_Mini-Circuits_FV1206
L801, L802: 6.8n; L_0603_1608Metric_Pad1.05x0.95mm_HandSolder
L803, L808: 100n; L_0603_1608Metric_Pad1.05x0.95mm_HandSolder
L804, L807: 22nH; L_0603_1608Metric_Pad1.05x0.95mm_HandSolder
L805, L806: 10n; L_0603_1608Metric_Pad1.05x0.95mm_HandSolder
R801: 100; R_0603_1608Metric_Pad0.98x0.95mm_HandSolder
R802, R803, R804, R805, R822, R823: 470; R_0402_1005Metric_Pad0.72x0.64mm_HandSolder
R806, R814: 51; R_0805_2012Metric_Pad1.20x1.40mm_HandSolder
R807, R808, R812: 10k; R_0603_1608Metric_Pad0.98x0.95mm_HandSolder
R809: 1k; R_0603_1608Metric_Pad0.98x0.95mm_HandSolder
R810, R811: 2.7k; R_0603_1608Metric_Pad0.98x0.95mm_HandSolder
R813, R815, R816: 18; R_0603_1608Metric_Pad0.98x0.95mm_HandSolder
R817: 0; R_0603_1608Metric_Pad0.98x0.95mm_HandSolder
R818, R819: DNP; R_0603_1608Metric_Pad0.98x0.95mm_HandSolder
R820: 51; R_0603_1608Metric
R821: 10; R_0402_1005Metric_Pad0.72x0.64mm_HandSolder
TR801: 1P620S
U801: NCP163ASN500T1G; SOT-23-5
U802: ADL5513; LFCSP-16-1EP_3x3mm_P0.5mm_EP1.7x1.7mm_ThermalVias
U803: MCP9800Ax-xOT; SOT-23-5
U804, U807: QCN-27+
U805, U806: GRF4003; DFN-6-1EP_2x2mm_P0.5mm_EP0.6x1.37mm

Connections:
3v3_RF: C803.2, R801.1, R821.1; also elsewhere on the board
5V5: C801.2, FB801.1; also elsewhere on the board
/DET_OUT: C821.1, C826.1, D801.2 (A2), R809.2, R812.1; also elsewhere on the board
/I2C_SCL: R804.1; also elsewhere on the board
/I2C_SDA: R822.1; also elsewhere on the board
/Output_PA/5V_PA: C815.2, C823.1, C824.1, C827.1, C828.1, C831.1, C832.1, L803.1, L808.1, R810.2, R811.1, U801.5 (VOUT)
/Output_PA/PA_Out: TR801.2 (OUT); also elsewhere on the board
/Output_PA/RF_IN: U804.1 (SUM); also elsewhere on the board
/Output_PA/Sample: R816.1; also elsewhere on the board
/TX_PA_EN: R802.1; also elsewhere on the board
GND: C801.1, C802.1, C803.1, C804.1, C805.2, C806.1, C808.1, C809.2, C810.2, C811.2, C812.2, C813.2, C814.2, C815.1, C816.2, C817.2, C818.1, C821.2, C822.2, C823.2, C824.2, C825.2, C826.2, C827.2, C828.2, C829.2, C830.2, C831.2, C832.2, C835.2, C836.2, C837.2, C838.2, C839.2, D801.1 (A1), FL801.2 (GND), FL801.4 (GND), L801.2, L802.2, R806.1, R808.2, R812.2, R814.1, R818.2, R819.2, R820.1, U801.2 (GND), U802.5 (GND), U802.6 (GND), U802.7 (GND), U802.8 (GND), U802.10 (COMM), U802.13 (GND), U802.15 (GND), U802.16 (GND), U802.17 (GND), U803.2 (GND), U804.2 (GND), U804.5 (GND), U805.2 (GND), U805.5 (GND), U805.6 (GND), U805.7 (GND), U806.2 (GND), U806.5 (GND), U806.6 (GND), U806.7 (GND), U807.2 (GND), U807.5 (GND); also elsewhere on the board
unnamed: C805.1, R802.2, R803.1
unnamed: C807.1, R813.2
unnamed: C810.1, C812.1, C814.1, C816.1, C818.2, FB803.1, R807.1, U802.1 (VPOS), U802.4 (VPOS)
unnamed: C811.1, R804.2, R805.1
unnamed: C835.1, L807.1, L808.2
unnamed: C836.1, L806.1, L807.2
unnamed: C837.1, L803.2, L804.1
unnamed: C838.1, L804.2, L805.1
unnamed: C839.1, R822.2, R823.1
unnamed: FB802.2, R801.2
unnamed: FB803.2, R821.2
unnamed: FL801.1 (IN), U807.1 (SUM)
unnamed: FL801.3 (OUT), TR801.1 (IN)
unnamed: R813.1, R815.2, R816.2
unnamed: R815.1, R817.1, R819.1
unnamed: R817.2, R818.1, TR801.4 (CPL)
unnamed: R820.2, TR801.3 (Term)
unnamed: R803.2, U801.3 (EN)
unnamed: C802.2, C804.2, C806.2, FB801.2, U801.1 (VIN)
unnamed: C817.1, U802.14 (CLPF)
unnamed: C807.2, U802.2 (INHI)
unnamed: C808.2, U802.3 (INLO)
unnamed: R807.2, R808.1, U802.9 (TADJ)
unnamed: R809.1, U802.11 (VSET), U802.12 (VOUT)
unnamed: R805.2, U803.4 (SCLK)
unnamed: R823.2, U803.5 (SDA)
unnamed: C809.1, C813.1, FB802.1, U803.1 (V_{DD})
unnamed: C820.1, L801.1, U804.6 (P1)
unnamed: C819.1, L802.1, U804.4 (P2)
unnamed: R806.2, U804.3 (TER)
unnamed: C822.1, R810.1, U805.1 (EN)
unnamed: C820.2, U805.3 (IN)
unnamed: C829.1, C833.1, L805.2, U805.4 (OUT)
unnamed: C825.1, R811.2, U806.1 (EN)
unnamed: C819.2, U806.3 (IN)
unnamed: C830.1, C834.2, L806.2, U806.4 (OUT)
unnamed: C834.1, U807.6 (P1)
unnamed: C833.2, U807.4 (P2)
unnamed: R814.2, U807.3 (TER)

Notes on the sheet:
tx: ~ -7/ 8 dBm
-20 dB sample
DNP
tx: ~ -7/ 4 dBm
tx: ~ -5/ 6 dBm
RF Detector
tx: ~ -17/ -2 dBm
tx: ~ -13/ 2 dBm

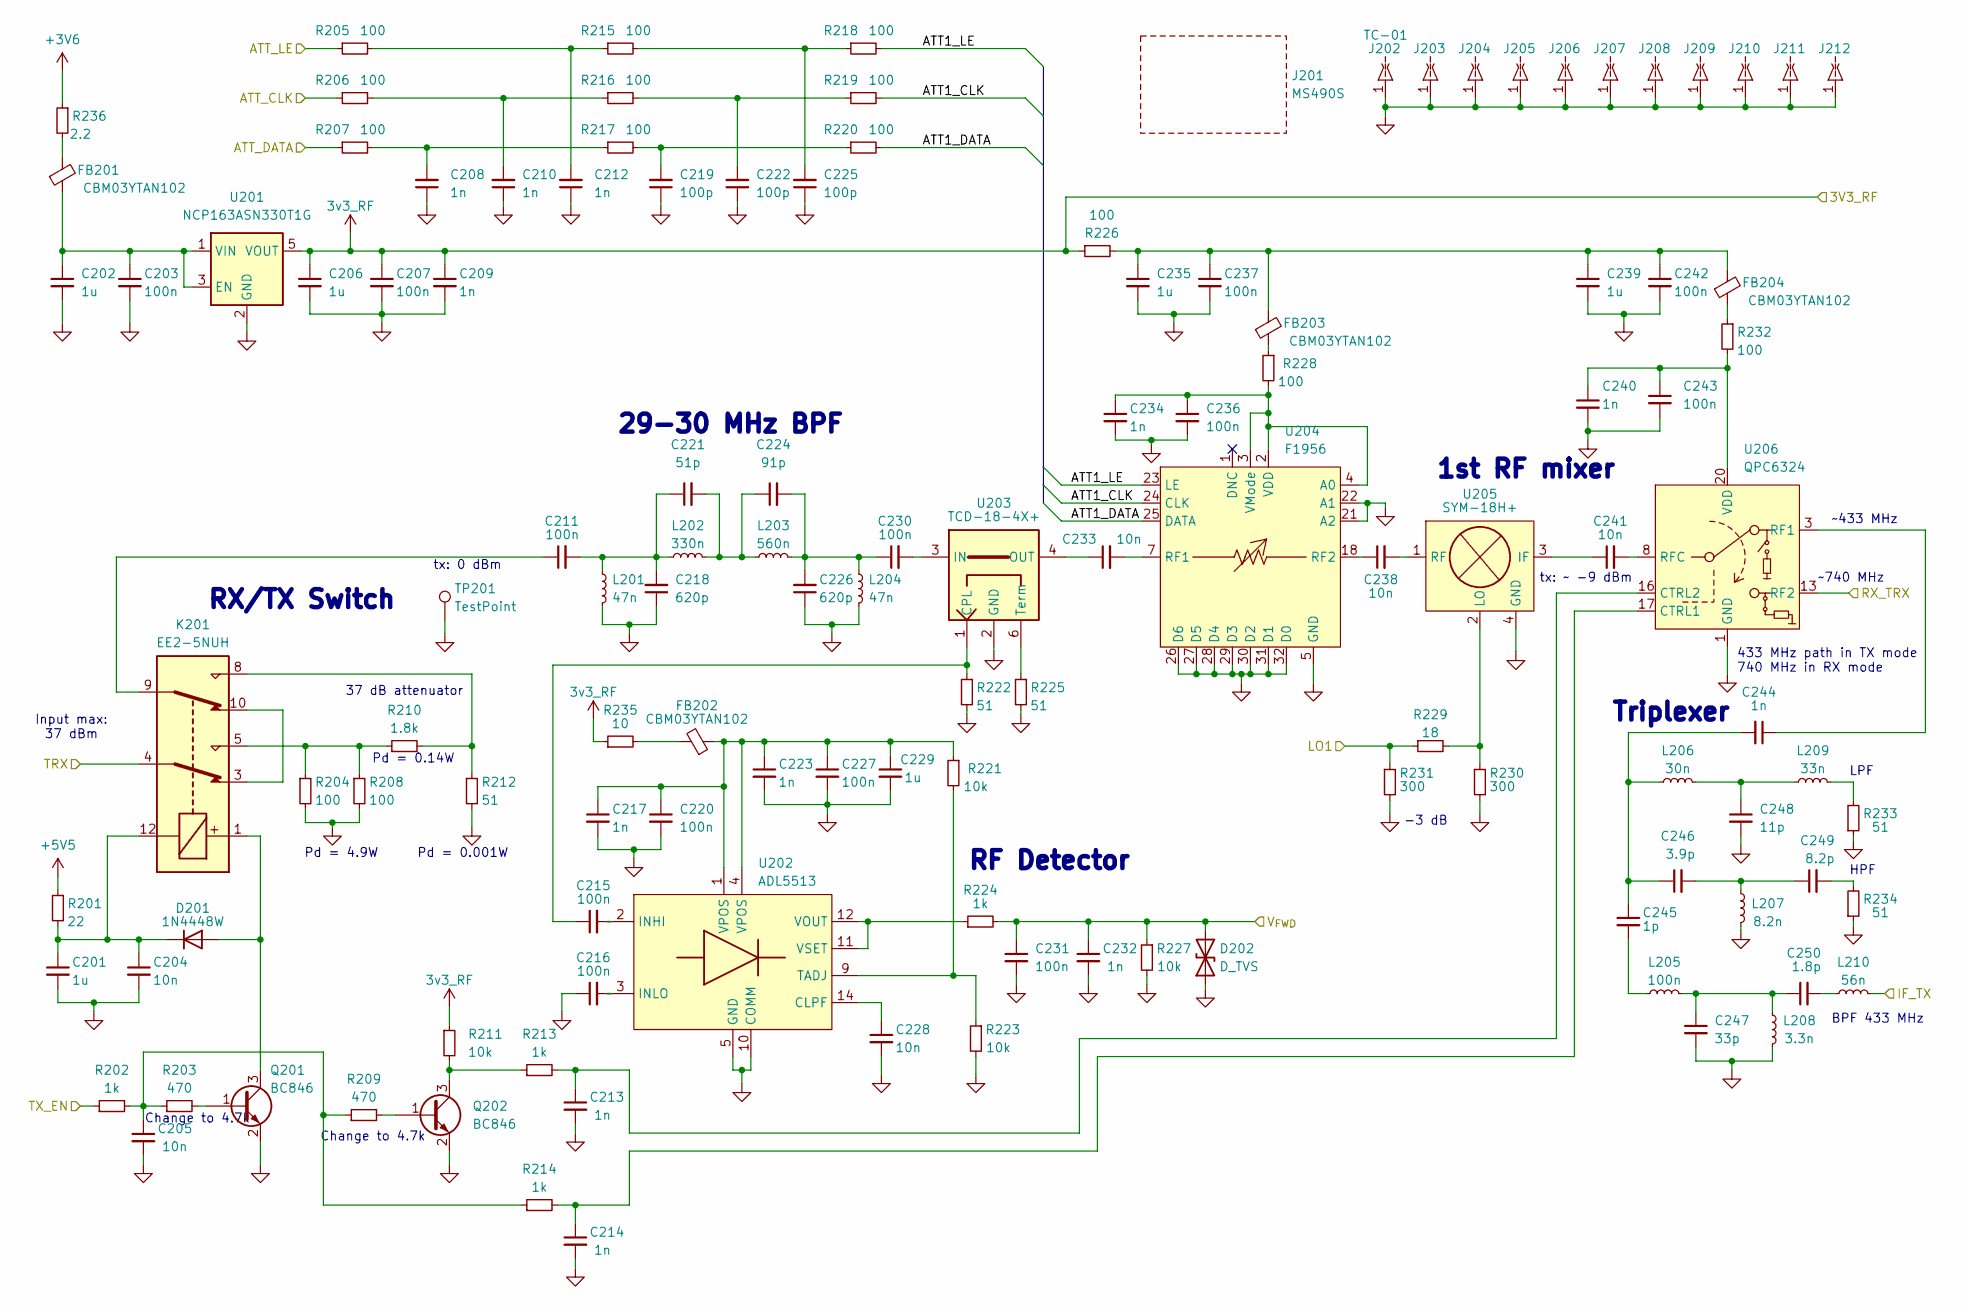
[picture p53: schematic Input_&_IF_Mixer.kicad_sch, Presto transverter]

Parts:
C201: 1u; C_0805_2012Metric_Pad1.18x1.45mm_HandSolder
C202, C206, C229, C235, C239: 1u; C_0603_1608Metric_Pad1.08x0.95mm_HandSolder
C203, C207, C211, C215, C216, C220, C227, C230, C231, C237, C242: 100n; C_0603_1608Metric_Pad1.08x0.95mm_HandSolder
C204, C205, C228, C233, C238, C241: 10n; C_0603_1608Metric_Pad1.08x0.95mm_HandSolder
C208, C210, C212, C213, C214, C234, C240: 1n; C_0402_1005Metric_Pad0.74x0.62mm_HandSolder
C209, C217, C223, C232, C244: 1n; C_0603_1608Metric_Pad1.08x0.95mm_HandSolder
C218, C226: 620p; C_0603_1608Metric_Pad1.08x0.95mm_HandSolder
C219, C222, C225: 100p; C_0402_1005Metric_Pad0.74x0.62mm_HandSolder
C221: 51p; C_0603_1608Metric_Pad1.08x0.95mm_HandSolder
C224: 91p; C_0603_1608Metric_Pad1.08x0.95mm_HandSolder
C236, C243: 100n; C_0402_1005Metric_Pad0.74x0.62mm_HandSolder
C245: 1p; C_0603_1608Metric_Pad1.08x0.95mm_HandSolder
C246: 3.9p; C_0603_1608Metric_Pad1.08x0.95mm_HandSolder
C247: 33p; C_0603_1608Metric_Pad1.08x0.95mm_HandSolder
C248: 11p; C_0603_1608Metric_Pad1.08x0.95mm_HandSolder
C249: 8.2p; C_0603_1608Metric_Pad1.08x0.95mm_HandSolder
C250: 1.8p; C_0603_1608Metric_Pad1.08x0.95mm_HandSolder
D201: 1N4448W; D_SOD-123
D202: D_TVS; D_SOD-323
FB201, FB202, FB203, FB204: CBM03YTAN102; L_0603_1608Metric_Pad1.05x0.95mm_HandSolder
J201: MS490S; MS490_Shield
J202, J210, J212: TC-01; TC-01_CLIP_LeaderTech_half
J203, J204, J205, J206, J207, J208, J209, J211: TC-01; TC-01_CLIP_LeaderTech
K201: EE2-5NUH; Relay_DPDT_Kemet_EE2_NUH
L201, L204: 47n; L_1008_2520Metric_Pad1.43x2.20mm_HandSolder
L202: 330n; L_1008_2520Metric_Pad1.43x2.20mm_HandSolder
L203: 560n; L_1008_2520Metric_Pad1.43x2.20mm_HandSolder
L205: 100n; L_0603_1608Metric_Pad1.05x0.95mm_HandSolder
L206: 30n; L_0603_1608Metric_Pad1.05x0.95mm_HandSolder
L207: 8.2n; L_0603_1608Metric_Pad1.05x0.95mm_HandSolder
L208: 3.3n; L_0603_1608Metric_Pad1.05x0.95mm_HandSolder
L209: 33n; L_0603_1608Metric_Pad1.05x0.95mm_HandSolder
L210: 56n; L_0603_1608Metric_Pad1.05x0.95mm_HandSolder
Q201, Q202: BC846; SOT-23
R201: 22; R_1206_3216Metric_Pad1.30x1.75mm_HandSolder
R202, R224: 1k; R_0603_1608Metric_Pad0.98x0.95mm_HandSolder
R203, R209: 470; R_0603_1608Metric_Pad0.98x0.95mm_HandSolder
R204, R208: 100; 3522_custom
R205, R206, R207, R215, R216, R217, R218, R219, R220, R228: 100; R_0402_1005Metric_Pad0.72x0.64mm_HandSolder
R210: 1.8k; R_1210_3225Metric_Pad1.30x2.65mm_HandSolder
R211, R221, R223, R227: 10k; R_0603_1608Metric_Pad0.98x0.95mm_HandSolder
R212: 51; R_1210_3225Metric_Pad1.30x2.65mm_HandSolder
R213, R214: 1k; R_0402_1005Metric_Pad0.72x0.64mm_HandSolder
R222, R225, R233, R234: 51; R_0603_1608Metric_Pad0.98x0.95mm_HandSolder
R226: 100; R_0603_1608Metric_Pad0.98x0.95mm_HandSolder
R229: 18; R_0603_1608Metric_Pad0.98x0.95mm_HandSolder
R230, R231: 300; R_0603_1608Metric_Pad0.98x0.95mm_HandSolder
R232: 100; C_0402_1005Metric_Pad0.74x0.62mm_HandSolder
R235: 10; R_0603_1608Metric_Pad0.98x0.95mm_HandSolder
R236: 2.2; R_0603_1608Metric_Pad0.98x0.95mm_HandSolder
TP201: TestPoint; TestPoint_Pad_4.0x4.0mm
U201: NCP163ASN330T1G; SOT-23-5
U202: ADL5513; LFCSP-16-1EP_3x3mm_P0.5mm_EP1.7x1.7mm_ThermalVias
U203: TCD-18-4X+; TCD-18-4x
U204: F1956; TQFN-32-1EP_5x5mm_P0.5mm_EP3.1x3.1mm
U205: SYM-18H+
U206: QPC6324; QPC6324_QFN20pinSMDQorvo

Connections:
3V6: R236.1; also elsewhere on the board
3v3_RF: C206.1, C207.1, C209.1, R211.1, R226.1, R235.1, U201.5 (VOUT); also elsewhere on the board
5V5: R201.1; also elsewhere on the board
/ATT_CLK: R206.1; also elsewhere on the board
/ATT_DATA: R207.1; also elsewhere on the board
/ATT_LE: R205.1; also elsewhere on the board
/Input_&_IF_Mixer/ATT1_CLK: R219.2, U204.24 (CLK)
/Input_&_IF_Mixer/ATT1_DATA: R220.2, U204.25 (DATA)
/Input_&_IF_Mixer/ATT1_LE: R218.2, U204.23 (LE)
/Input_&_IF_Mixer/IF_TX: L210.2; also elsewhere on the board
/Input_&_IF_Mixer/LO1: R229.1, R231.1; also elsewhere on the board
/Input_&_IF_Mixer/RX_TRX: U206.13 (RF2); also elsewhere on the board
/Input_&_IF_Mixer/TRX: K201.4; also elsewhere on the board
/TX_EN: R202.1; also elsewhere on the board
/V_{FWD}: C231.1, C232.1, D202.2 (A2), R224.2, R227.1; also elsewhere on the board
GND: C201.2, C202.2, C203.2, C204.2, C205.2, C206.2, C207.2, C208.1, C209.2, C210.1, C212.1, C213.2, C214.2, C216.1, C217.2, C218.1, C219.1, C220.2, C222.1, C223.2, C225.1, C226.1, C227.2, C228.2, C229.2, C231.2, C232.2, C234.2, C235.2, C236.2, C237.2, C239.2, C240.2, C242.2, C243.2, C247.2, C248.2, D202.1 (A1), J202.1, J203.1, J204.1, J205.1, J206.1, J207.1, J208.1, J209.1, J210.1, J211.1, J212.1, L201.2, L204.2, L207.2, L208.2, Q201.2 (E), Q202.2 (E), R204.2, R208.2, R212.2, R222.2, R223.2, R225.2, R227.2, R230.2, R231.2, R233.1, R234.1, TP201.1, U201.2 (GND), U202.5 (GND), U202.6 (GND), U202.7 (GND), U202.8 (GND), U202.10 (COMM), U202.13 (GND), U202.15 (GND), U202.16 (GND), U202.17 (GND), U203.2 (GND), U203.5 (GND), U204.5 (GND), U204.6 (GND), U204.8 (GND), U204.9 (GND), U204.10 (GND), U204.11 (GND), U204.12 (GND), U204.13 (GND), U204.14 (GND), U204.15 (GND), U204.16 (GND), U204.17 (GND), U204.19 (GND), U204.20 (GND), U204.21 (A2), U204.22 (A1), U204.26 (D6), U204.27 (D5), U204.28 (D4), U204.29 (D3), U204.30 (D2), U204.31 (D1), U204.32 (D0), U204.33 (GND), U205.4 (GND), U205.5 (GND), U205.6 (GND), U206.1 (GND), U206.2 (GND), U206.4 (GND), U206.5 (GND), U206.6 (GND), U206.7 (GND), U206.9 (GND), U206.10 (GND), U206.11 (GND), U206.12 (GND), U206.14 (GND), U206.15 (GND), U206.18 (GND), U206.19 (GND), U206.21 (GND); also elsewhere on the board
unnamed: C205.1, R202.2, R203.1, R209.1, R214.1
unnamed: C208.2, R207.2, R217.1
unnamed: C210.2, R206.2, R216.1
unnamed: C211.1, K201.9
unnamed: C211.2, C218.2, C221.1, L201.1, L202.1
unnamed: C212.2, R205.2, R215.1
unnamed: C217.1, C220.1, C223.1, C227.1, C229.1, FB202.1, R221.1, U202.1 (VPOS), U202.4 (VPOS)
unnamed: C219.2, R217.2, R220.1
unnamed: C221.2, C224.1, L202.2, L203.1
unnamed: C222.2, R216.2, R219.1
unnamed: C224.2, C226.2, C230.1, L203.2, L204.1
unnamed: C225.2, R215.2, R218.1
unnamed: C235.1, C237.1, C239.1, C242.1, FB203.2, FB204.2, R226.2
unnamed: C245.2, L205.1
unnamed: C246.2, C249.1, L207.1
unnamed: C247.1, C250.1, L205.2, L208.1
unnamed: C248.1, L206.2, L209.1
unnamed: C249.2, R234.2
unnamed: C250.2, L210.1
unnamed: D201.2 (A), K201.1, Q201.3 (C)
unnamed: C201.1, C204.1, D201.1 (K), K201.12, R201.2
unnamed: FB201.2, R236.2
unnamed: FB202.2, R235.2
unnamed: FB203.1, R228.1
unnamed: FB204.1, R232.1
unnamed: K201.5, R204.1, R208.1, R210.1
unnamed: K201.8, R210.2, R212.1
unnamed: K201.3, K201.10
unnamed: L209.2, R233.2
unnamed: Q201.1 (B), R203.2
unnamed: Q202.1 (B), R209.2
unnamed: Q202.3 (C), R211.2, R213.1
unnamed: C202.1, C203.1, FB201.1, U201.1 (VIN), U201.3 (EN)
unnamed: C228.1, U202.14 (CLPF)
unnamed: C215.2, U202.2 (INHI)
unnamed: C216.2, U202.3 (INLO)
unnamed: R221.2, R223.1, U202.9 (TADJ)
unnamed: R224.1, U202.11 (VSET), U202.12 (VOUT)
unnamed: C215.1, R222.1, U203.1 (CPL)
unnamed: C230.2, U203.3 (IN)
unnamed: C233.1, U203.4 (OUT)
unnamed: R225.1, U203.6 (Term)
unnamed: C234.1, C236.1, R228.2, U204.2 (VDD), U204.3 (VMode), U204.4 (A0)
unnamed: C233.2, U204.7 (RF1)
unnamed: C238.1, U204.18 (RF2)
unnamed: C241.1, U205.3 (IF)
unnamed: R229.2, R230.1, U205.2 (LO)
unnamed: C238.2, U205.1 (RF)
unnamed: C214.1, R214.2, U206.17 (CTRL1)
unnamed: C213.1, R213.2, U206.16 (CTRL2)
unnamed: C241.2, U206.8 (RFC)
unnamed: C240.1, C243.1, R232.2, U206.20 (VDD)

Notes on the sheet:
HPF
Pd = 4.9W
Input max: 37 dBm
37 dB attenuator
RF Detector
Pd = 0.001W
RX/TX Switch
tx: ~ -9 dBm
Triplexer
~433 MHz
BPF 433 MHz
LPF
Pd = 0.14W
Change to 4.7k
1st RF mixer
29-30 MHz BPF
433 MHz path in TX mode 740 MHz in RX mode
-3 dB
tx: 0 dBm
~740 MHz
