SP6GK/Presto-Transverter/ECAD/KiCad_0006_PrestoMB_rev01a/0006_PrestoMB.kicad_pcb

## KiCad design ECAD/KiCad_0006_PrestoMB_rev01a/0006_PrestoMB.kicad_pcb (continued)

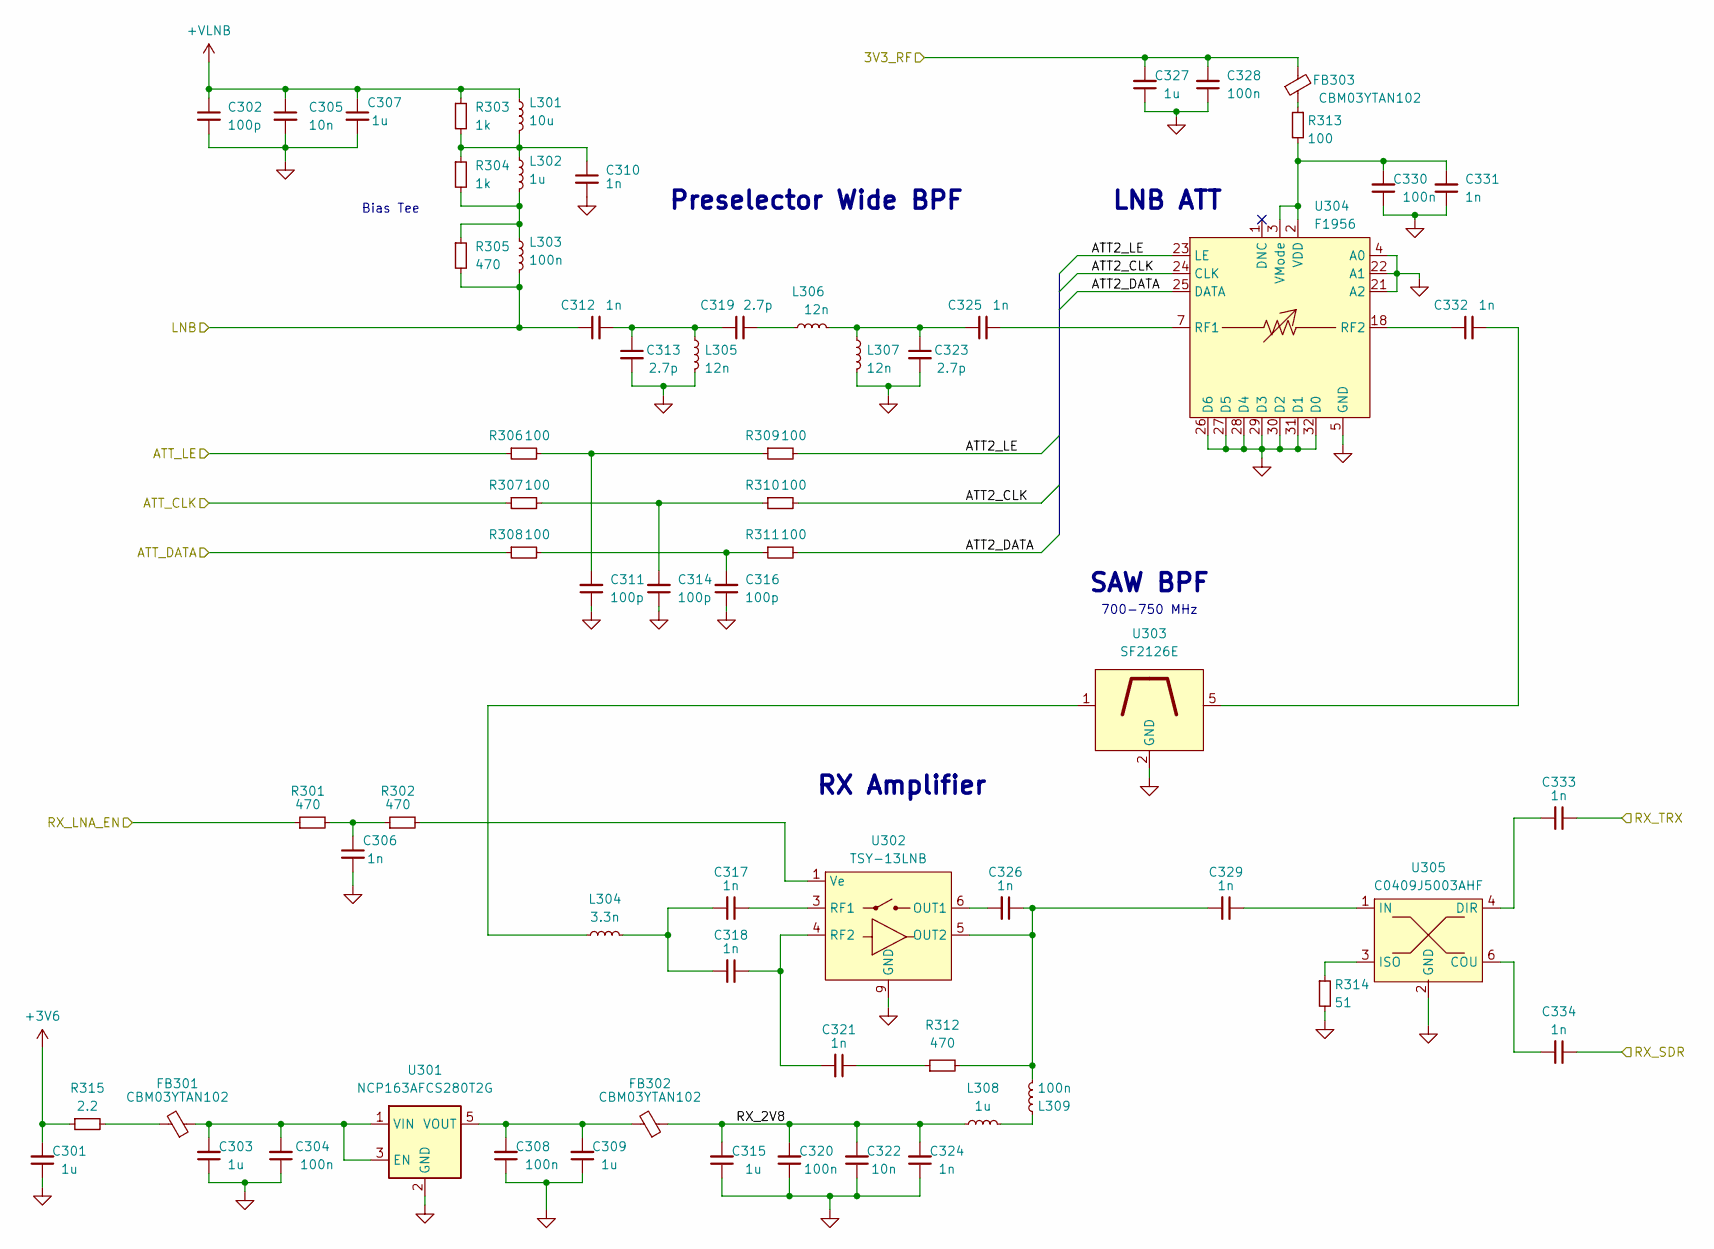
[picture p54: schematic RX_LNB.kicad_sch, Presto transverter]

Parts:
C301, C303, C309, C315, C327: 1u; C_0603_1608Metric_Pad1.08x0.95mm_HandSolder
C302: 100p; C_0805_2012Metric_Pad1.18x1.45mm_HandSolder
C304, C308, C320, C328: 100n; C_0603_1608Metric_Pad1.08x0.95mm_HandSolder
C305: 10n; C_0805_2012Metric_Pad1.18x1.45mm_HandSolder
C306: 1n; C_0603_1608Metric
C307: 1u; C_1206_3216Metric_Pad1.33x1.80mm_HandSolder
C310: 1n; C_1206_3216Metric_Pad1.33x1.80mm_HandSolder
C311, C314, C316: 100p; C_0603_1608Metric_Pad1.08x0.95mm_HandSolder
C312: 1n; C_0805_2012Metric
C313, C319, C323: 2.7p; C_0603_1608Metric
C317, C318, C321, C326, C329, C331, C333, C334: 1n; C_0402_1005Metric_Pad0.74x0.62mm_HandSolder
C322: 10n; C_0603_1608Metric_Pad1.08x0.95mm_HandSolder
C324, C325, C332: 1n; C_0603_1608Metric_Pad1.08x0.95mm_HandSolder
C330: 100n; C_0402_1005Metric_Pad0.74x0.62mm_HandSolder
FB301, FB302, FB303: CBM03YTAN102; L_0603_1608Metric_Pad1.05x0.95mm_HandSolder
L301: 10u; L_1210_3225Metric_Pad1.42x2.65mm_HandSolder
L302: 1u; L_0805_2012Metric_Pad1.15x1.40mm_HandSolder
L303: 100n; L_0603_1608Metric_Pad1.05x0.95mm_HandSolder
L304: 3.3n; L_0603_1608Metric_Pad1.05x0.95mm_HandSolder
L305, L306, L307: 12n; L_0603_1608Metric
L308: 1u; L_0805_2012Metric_Pad1.05x1.20mm_HandSolder
L309: 100n; L_0603_1608Metric
R301, R302: 470; R_0402_1005Metric_Pad0.72x0.64mm_HandSolder
R303, R304: 1k; R_0805_2012Metric_Pad1.20x1.40mm_HandSolder
R305: 470; R_0603_1608Metric_Pad0.98x0.95mm_HandSolder
R306, R307, R308, R309, R310, R311, R313: 100; R_0402_1005Metric_Pad0.72x0.64mm_HandSolder
R312: 470; C_0402_1005Metric_Pad0.74x0.62mm_HandSolder
R314: 51; R_0603_1608Metric_Pad0.98x0.95mm_HandSolder
R315: 2.2; R_0402_1005Metric_Pad0.72x0.64mm_HandSolder
U301: NCP163AFCS280T2G; SOT-23-5
U302: TSY-13LNB; MiniCircuits_MC163_TSY13LNB
U303: SF2126E; 3x3mm_RFMI_SF2126E
U304: F1956; TQFN-32-1EP_5x5mm_P0.5mm_EP3.1x3.1mm
U305: C0409J5003AHF

Connections:
3V6: C301.2, R315.1; also elsewhere on the board
3v3_RF: C327.2, C328.2, FB303.2; also elsewhere on the board
+VLNB: C302.1, C305.1, C307.1, L301.1, R303.1; also elsewhere on the board
/ATT_CLK: R307.1; also elsewhere on the board
/ATT_DATA: R308.1; also elsewhere on the board
/ATT_LE: R306.1; also elsewhere on the board
/Input_&_IF_Mixer/RX_TRX: C333.1; also elsewhere on the board
/RX_LNA_EN: R301.1; also elsewhere on the board
/RX_LNB/ATT2_CLK: R310.2, U304.24 (CLK)
/RX_LNB/ATT2_DATA: R311.2, U304.25 (DATA)
/RX_LNB/ATT2_LE: R309.2, U304.23 (LE)
/RX_LNB/LNB: C312.1, L303.2, R305.2; also elsewhere on the board
/RX_LNB/RX_2V8: C315.2, C320.2, C322.2, C324.2, FB302.1, L308.2
/RX_LNB/RX_SDR: C334.1; also elsewhere on the board
GND: C301.1, C302.2, C303.1, C304.1, C305.2, C306.2, C307.2, C308.1, C309.1, C310.2, C311.1, C313.2, C314.1, C315.1, C316.1, C320.1, C322.1, C323.2, C324.1, C327.1, C328.1, C330.1, C331.1, L305.2, L307.2, R314.2, U301.2 (GND), U302.2 (GND), U302.7 (GND), U302.8 (GND), U302.9 (GND), U303.2 (GND), U303.3 (GND), U303.4 (GND), U303.6 (GND), U303.7 (GND), U303.8 (GND), U304.4 (A0), U304.5 (GND), U304.6 (GND), U304.8 (GND), U304.9 (GND), U304.10 (GND), U304.11 (GND), U304.12 (GND), U304.13 (GND), U304.14 (GND), U304.15 (GND), U304.16 (GND), U304.17 (GND), U304.19 (GND), U304.20 (GND), U304.21 (A2), U304.22 (A1), U304.26 (D6), U304.27 (D5), U304.28 (D4), U304.29 (D3), U304.30 (D2), U304.31 (D1), U304.32 (D0), U304.33 (GND), U305.2 (GND), U305.5 (GND); also elsewhere on the board
unnamed: C306.1, R301.2, R302.1
unnamed: C310.1, L301.2, L302.1, R303.2, R304.1
unnamed: C311.2, R306.2, R309.1
unnamed: C312.2, C313.1, C319.1, L305.1
unnamed: C314.2, R307.2, R310.1
unnamed: C316.2, R308.2, R311.1
unnamed: C317.2, C318.2, L304.2
unnamed: C319.2, L306.1
unnamed: C321.1, R312.1
unnamed: C323.1, C325.1, L306.2, L307.1
unnamed: C332.2, U303.5
unnamed: FB301.2, R315.2
unnamed: FB303.1, R313.1
unnamed: L302.2, L303.1, R304.2, R305.1
unnamed: L304.1, U303.1
unnamed: L308.1, L309.2
unnamed: C303.2, C304.2, FB301.1, U301.1 (VIN), U301.3 (EN)
unnamed: C308.2, C309.2, FB302.2, U301.5 (VOUT)
unnamed: C326.2, U302.6 (OUT1)
unnamed: C326.1, C329.2, L309.1, R312.2, U302.5 (OUT2)
unnamed: C317.1, U302.3 (RF1)
unnamed: C318.1, C321.2, U302.4 (RF2)
unnamed: R302.2, U302.1 (Ve)
unnamed: C325.2, U304.7 (RF1)
unnamed: C332.1, U304.18 (RF2)
unnamed: C330.2, C331.2, R313.2, U304.2 (VDD), U304.3 (VMode)
unnamed: C334.2, U305.6 (COU)
unnamed: C333.2, U305.4 (DIR)
unnamed: C329.1, U305.1 (IN)
unnamed: R314.1, U305.3 (ISO)

Notes on the sheet:
LNB ATT
700-750 MHz
Preselector Wide BPF
RX Amplifier
Bias Tee
SAW BPF

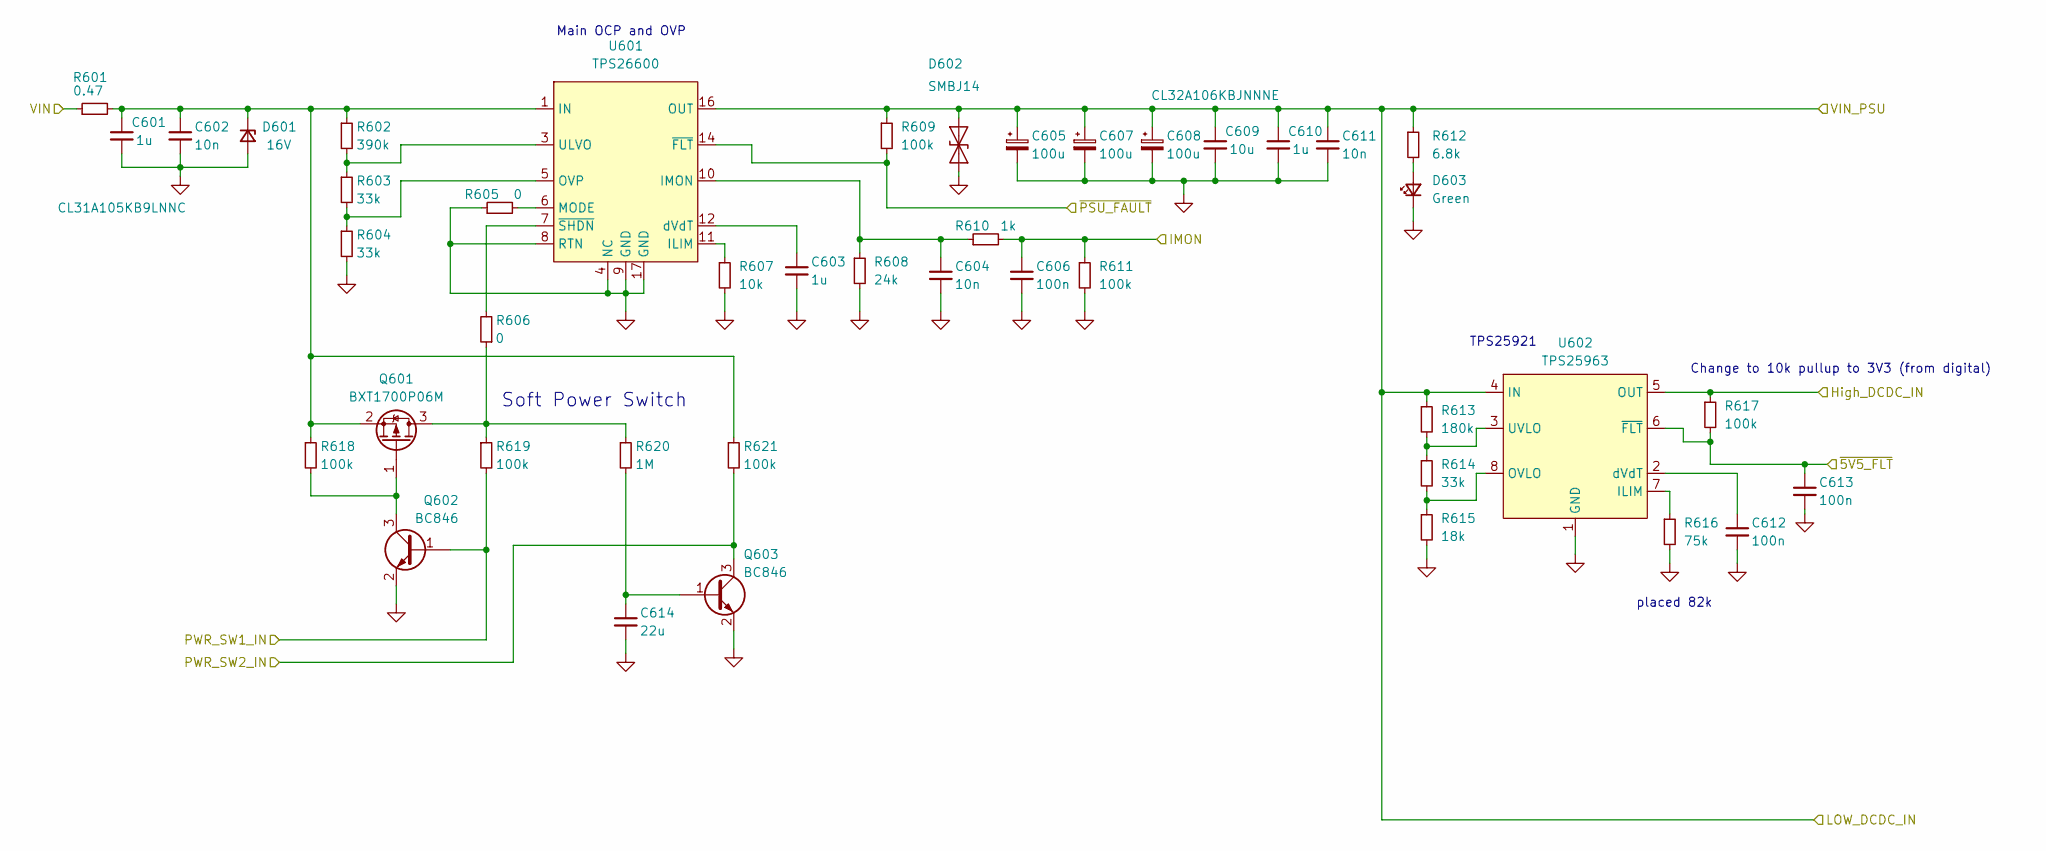
[picture p55: schematic PSU_Input_Protection.kicad_sch, Presto transverter]

Parts:
C601, C610: 1u; C_1206_3216Metric_Pad1.33x1.80mm_HandSolder
C602, C611: 10n; C_0805_2012Metric_Pad1.18x1.45mm_HandSolder
C603: 1u; C_0805_2012Metric_Pad1.18x1.45mm_HandSolder
C604: 10n; C_0402_1005Metric_Pad0.74x0.62mm_HandSolder
C605, C607, C608: 100u; CP_Elec_10x10.5
C606: 100n; C_0402_1005Metric_Pad0.74x0.62mm_HandSolder
C609: 10u; C_1210_3225Metric_Pad1.33x2.70mm_HandSolder
C612, C613: 100n; C_0805_2012Metric_Pad1.18x1.45mm_HandSolder
C614: 22u; C_0805_2012Metric_Pad1.18x1.45mm_HandSolder
D601: 16V; D_SMA
D602: SMBJ14; D_SMA
D603: Green; D_0805_2012Metric_Pad1.15x1.40mm_HandSolder
Q601: BXT1700P06M; SOT-23
Q602, Q603: BC846; SOT-23
R601: 0.47; R_1206_3216Metric_Pad1.30x1.75mm_HandSolder
R602: 390k; R_0805_2012Metric_Pad1.20x1.40mm_HandSolder
R603, R604, R614: 33k; R_0805_2012Metric_Pad1.20x1.40mm_HandSolder
R605, R606: 0; R_0603_1608Metric_Pad0.98x0.95mm_HandSolder
R607: 10k; R_0603_1608Metric_Pad0.98x0.95mm_HandSolder
R608: 24k; R_0603_1608Metric_Pad0.98x0.95mm_HandSolder
R609, R617: 100k; R_0603_1608Metric_Pad0.98x0.95mm_HandSolder
R610: 1k; R_0402_1005Metric_Pad0.72x0.64mm_HandSolder
R611: 100k; R_0402_1005Metric_Pad0.72x0.64mm_HandSolder
R612: 6.8k; R_0603_1608Metric_Pad0.98x0.95mm_HandSolder
R613: 180k; R_0805_2012Metric_Pad1.20x1.40mm_HandSolder
R615: 18k; R_0805_2012Metric_Pad1.20x1.40mm_HandSolder
R616: 75k; R_0603_1608Metric_Pad0.98x0.95mm_HandSolder
R618, R619, R621: 100k; R_0805_2012Metric_Pad1.20x1.40mm_HandSolder
R620: 1M; R_0805_2012Metric_Pad1.20x1.40mm_HandSolder
U601: TPS26600; HTSSOP-16-1EP_4.4x5mm_P0.65mm_EP3.4x5mm_Mask2.46x2.31mm
U602: TPS25963; SOIC-8-1EP_3.9x4.9mm_P1.27mm_EP2.62x3.51mm

Connections:
+VIN: C605.1, C607.1, C608.1, C609.1, C610.1, C611.1, D602.1 (A1), R609.1, R612.1, R613.1, U601.15 (OUT), U601.16 (OUT), U602.4 (IN); also elsewhere on the board
/PSU_LNB/PSU_Input_Protection/High_DCDC_IN: R617.1, U602.5 (OUT); also elsewhere on the board
/PSU_LNB/PSU_Input_Protection/IMON: C606.1, R610.2, R611.1; also elsewhere on the board
/PSU_LNB/PSU_Input_Protection/~5V5_FLT: C613.1, R617.2, U602.6 (~FLT); also elsewhere on the board
/PSU_LNB/PSU_Input_Protection/~PSU_FAULT: R609.2, U601.14 (~FLT); also elsewhere on the board
/PSU_LNB/PW_SW1: Q602.1 (B), R619.2; also elsewhere on the board
/PSU_LNB/PW_SW2: Q603.3 (C), R621.2; also elsewhere on the board
/PSU_LNB/VIN: R601.1; also elsewhere on the board
GND: C601.2, C602.2, C603.2, C604.2, C605.2, C606.2, C607.2, C608.2, C609.2, C610.2, C611.2, C612.2, C613.2, C614.2, D601.2 (A), D602.2 (A2), D603.1 (K), Q602.2 (E), Q603.2 (E), R604.2, R605.1, R607.2, R608.2, R611.2, R615.2, R616.2, U601.4 (NC), U601.8 (RTN), U601.9 (GND), U601.13 (NC), U601.17 (GND), U602.1 (GND), U602.9 (GND); also elsewhere on the board
unnamed: C601.1, C602.1, D601.1 (K), Q601.2, R601.2, R602.1, R618.1, R621.1, U601.1 (IN), U601.2 (IN)
unnamed: D603.2 (A), R612.2
unnamed: Q601.3, R606.1, R619.1, R620.1
unnamed: Q601.1, Q602.3 (C), R618.2
unnamed: C614.1, Q603.1 (B), R620.2
unnamed: R607.1, U601.11 (ILIM)
unnamed: C604.1, R608.1, R610.1, U601.10 (IMON)
unnamed: R605.2, U601.6 (MODE)
unnamed: R603.2, R604.1, U601.5 (OVP)
unnamed: R602.2, R603.1, U601.3 (ULVO)
unnamed: C603.1, U601.12 (dVdT)
unnamed: R606.2, U601.7 (~SHDN)
unnamed: R616.1, U602.7 (ILIM)
unnamed: R614.2, R615.1, U602.8 (OVLO)
unnamed: R613.2, R614.1, U602.3 (UVLO)
unnamed: C612.1, U602.2 (dVdT)

Notes on the sheet:
Change to 10k pullup to 3V3 (from digital)
Main OCP and OVP
TPS25921
placed 82k
Soft Power Switch

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
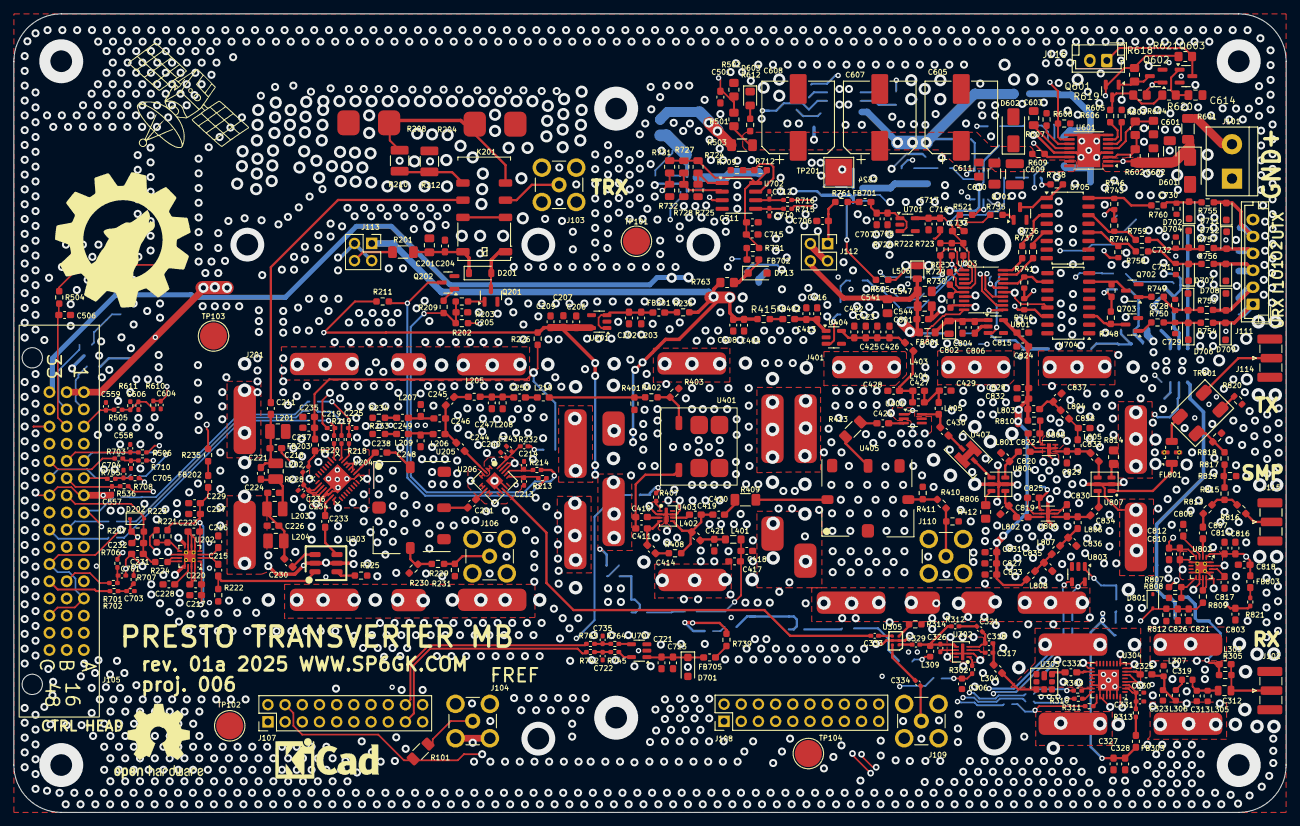
[picture p56: board 0006_PrestoMB.kicad_pcb from above]

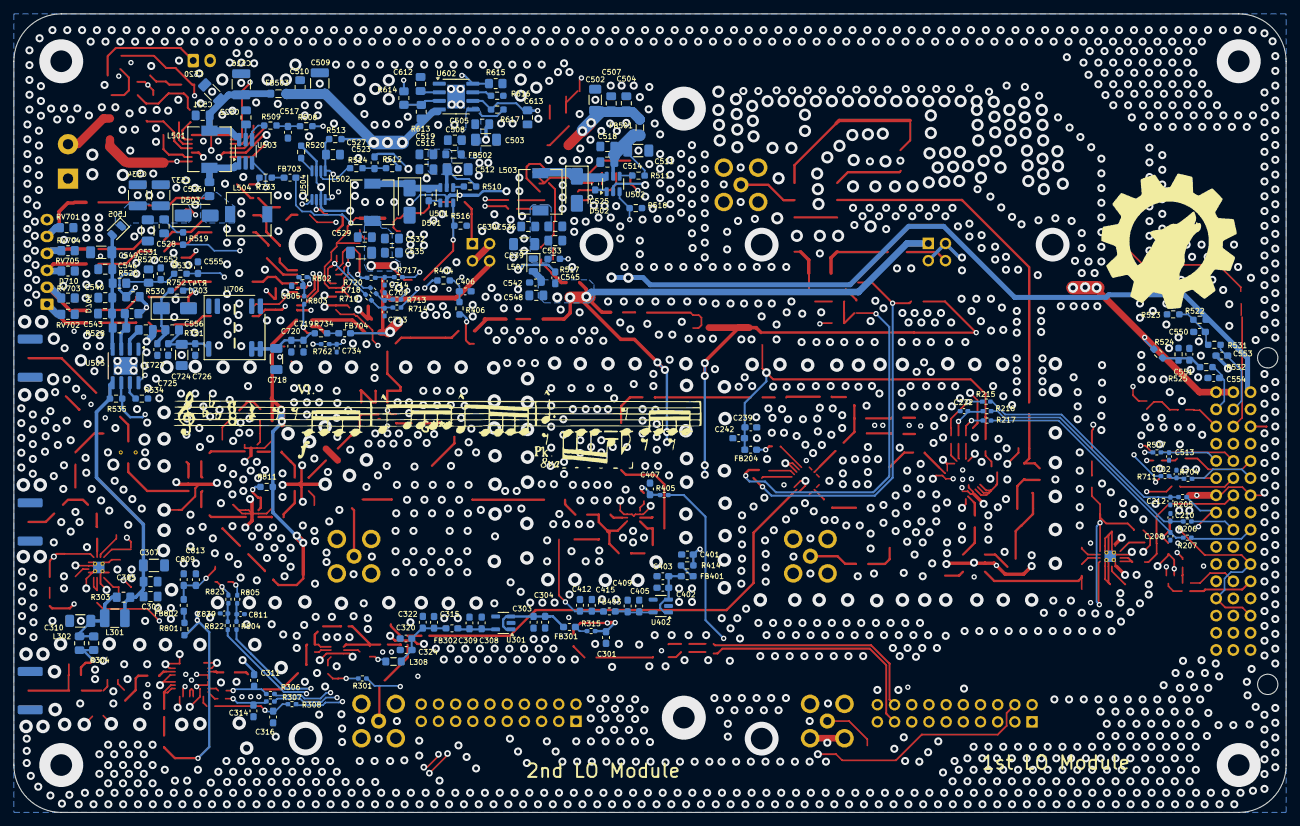
[picture p57: board 0006_PrestoMB.kicad_pcb from below]

Board: 4 copper layers, 188.0 x 118.0 mm, 666 parts (209 on the bottom side), 340 nets.

Other parts of the board:
J413#2, J413#3, J413#4, J413#5: TC-01; TC-01_CLIP_LeaderTech
J**: MS350-20S

Their connections:
GND: J413#2.1, J413#3.1, J413#4.1, J413#5.1; also elsewhere on the board
