SP6GK/Presto-Transverter/(notices)

Notices in the files:
MCAD/MCAD_0006_PrestoMB_rev01a/09231486921.stp:
author */ ('License CC BY-ND 4.0'),
